LPRD/Avionics_PCB/README.md

# Avionics_PCB
EAGLE Board and schematic files
