LPRD/Avionics_PCB/Flight/CALIPSO_V3-0/Images/CALIPSO_V3-0_Render_Right1.png

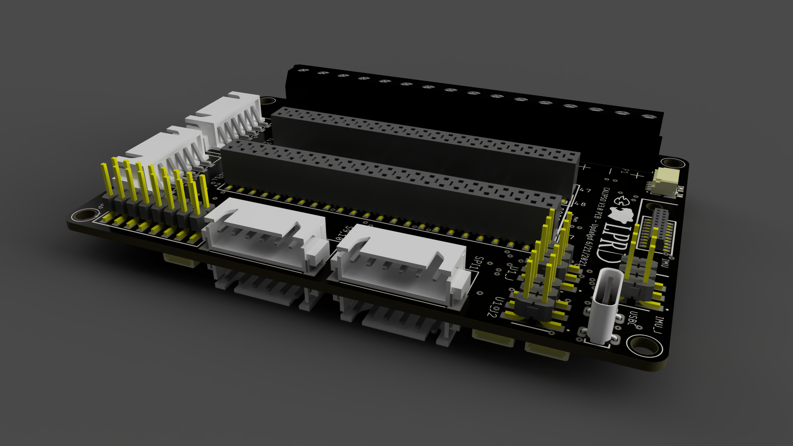
Flight/CALIPSO_V3-0/Images/CALIPSO_V3-0_Render_Right1.png
