LPRD/Avionics_PCB/Flight/CALIPSO_V3-0/Images/Eagle/CALIPSO_V3-0_Back.png

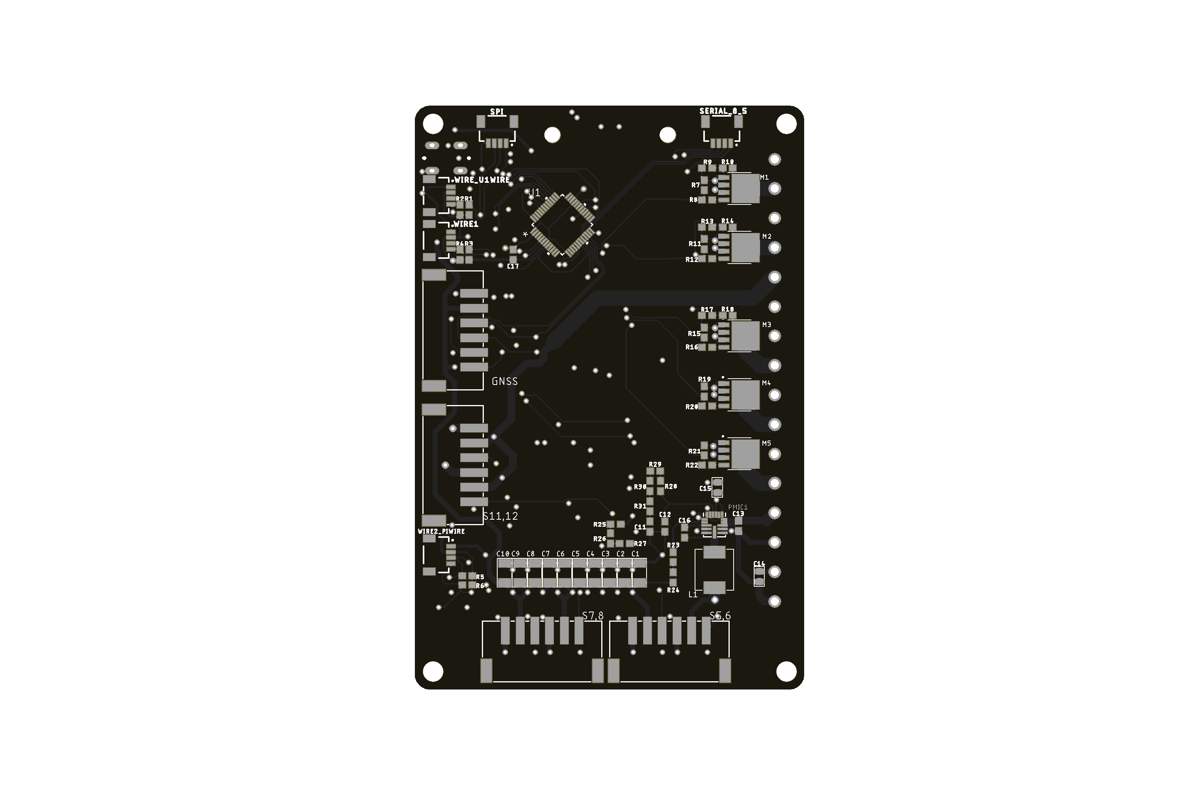
Flight/CALIPSO_V3-0/Images/Eagle/CALIPSO_V3-0_Back.png
