LPRD/Avionics_PCB/Flight/CALIPSO_V3-0/Images/Eagle/CALIPSO_V3-0_Front.png

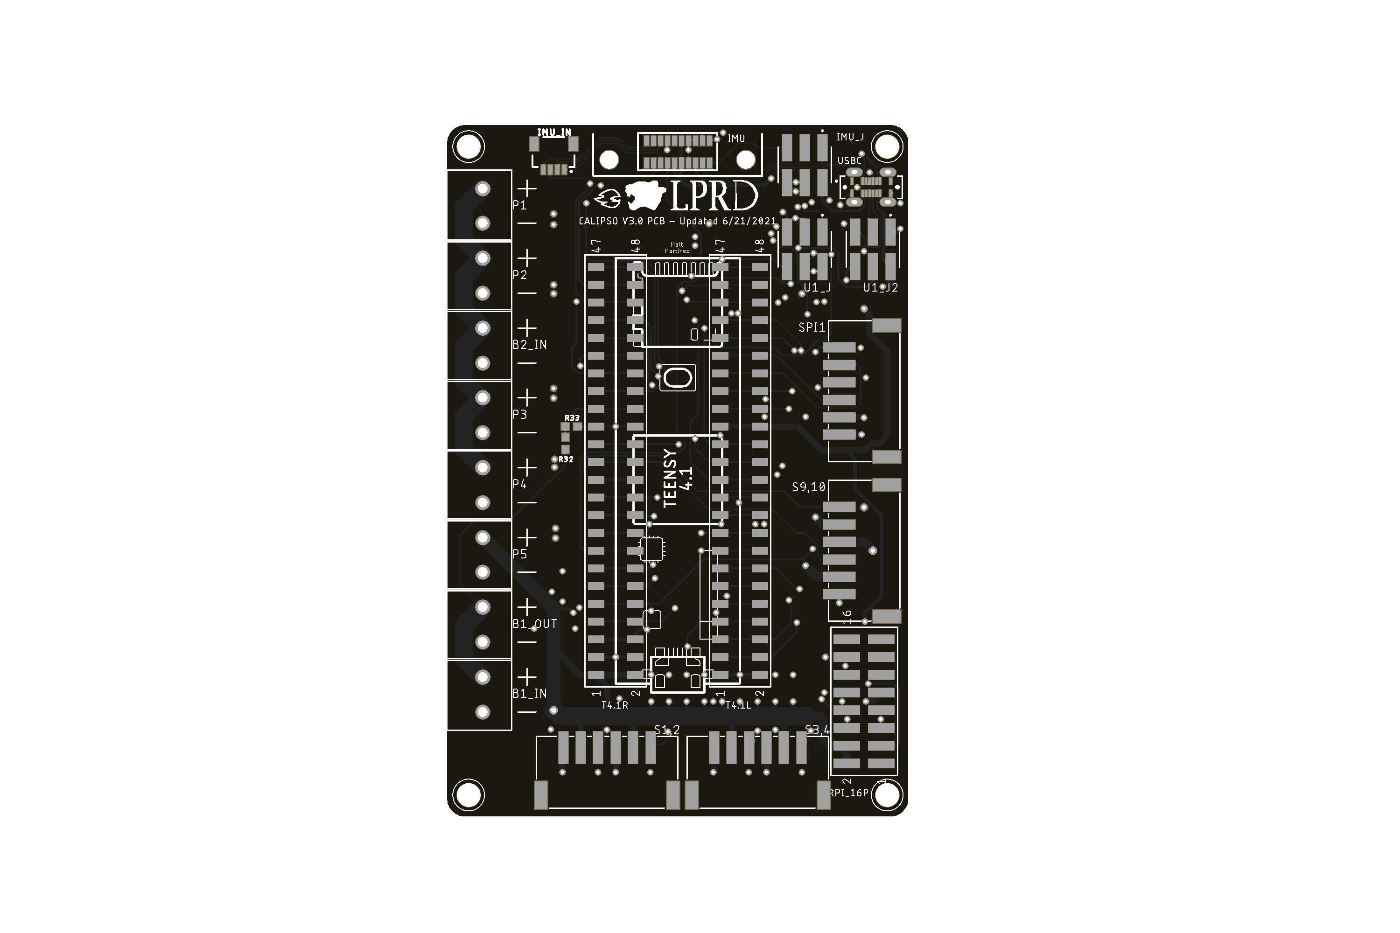
Flight/CALIPSO_V3-0/Images/Eagle/CALIPSO_V3-0_Front.png
