LPRD/Avionics_PCB/Flight/CALIPSO_V3-0/Images/Shareable/CALIPSO_V3-0_Render_Bottom45Corner1.png

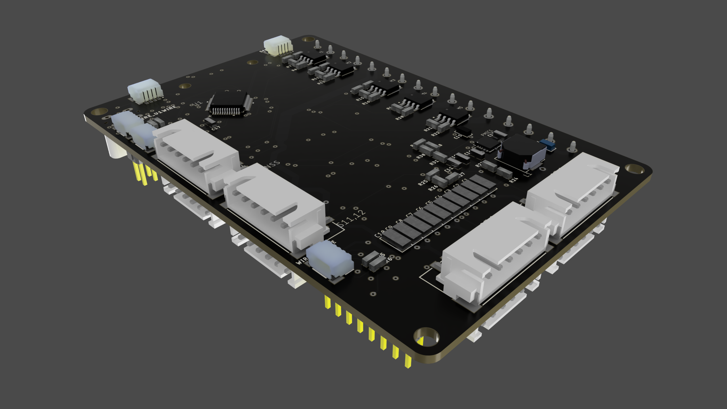
Flight/CALIPSO_V3-0/Images/Shareable/CALIPSO_V3-0_Render_Bottom45Corner1.png
