LPRD/Avionics_PCB/Flight/CALIPSO_V3-0/Images/Eagle/CALIPSO_V3-0_Front.dxf

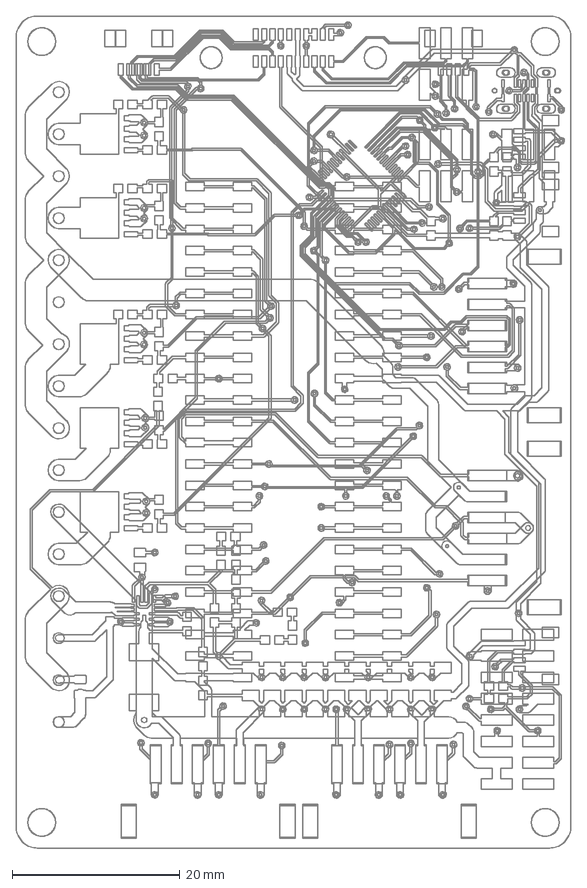
[picture p16: CAD file, 2022-03-29]
Flight/CALIPSO_V3-0/Images/Eagle/CALIPSO_V3-0_Front.dxf
66.0 x 99.1 mm
