LPRD/Avionics_PCB/Flight/CALIPSO_V3-0/Images/Eagle/CALIPSO_V3-0_Back.dxf

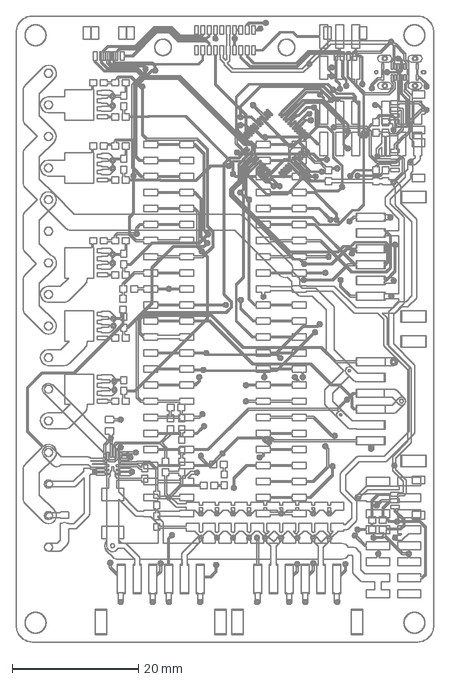
[picture p17: CAD file, 2022-03-29]
Flight/CALIPSO_V3-0/Images/Eagle/CALIPSO_V3-0_Back.dxf
66.0 x 99.1 mm
