LPRD/Avionics_PCB/ValveControl/TODO.md

# Things to fix in the valve control PCB
* Test stand blinkenlights
  * 4 of valve outputs?
  * Ignition arm/fire?
* Use switch on test stand: valve master on / off / use control panel valve master
