LPRD/Avionics_PCB/Flight/FA_2021/FA_2021_PCB_BRD_all.pdf

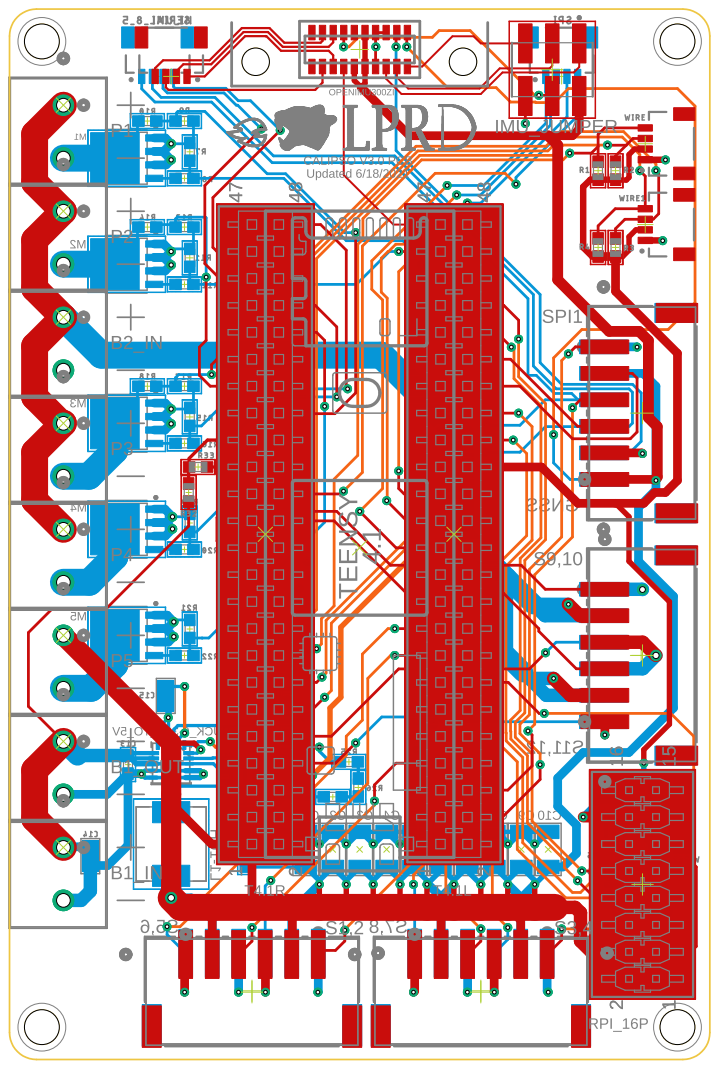
[picture p18: page 1]
