LPRD/Avionics_PCB/Flight/FA_2021/FA_2021_PCB_BRD_all_flipped.pdf

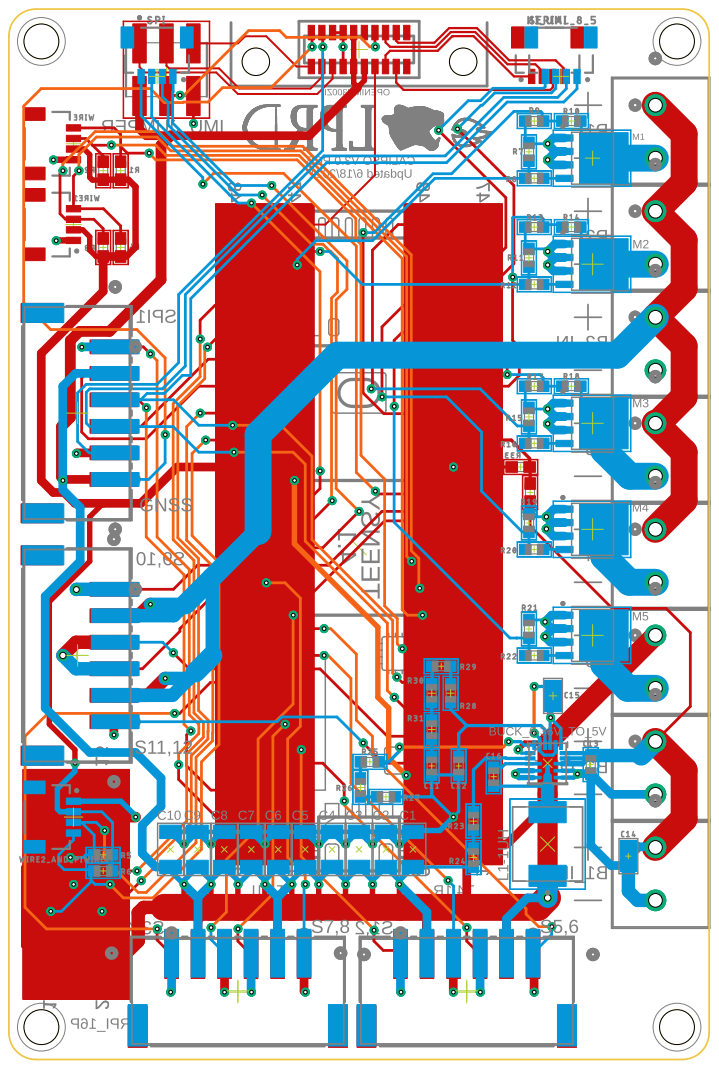
[picture p19: page 1]
