LPRD/Avionics_PCB/Flight/FA_2021/FA_2021_PCB_BRD_layer1.pdf

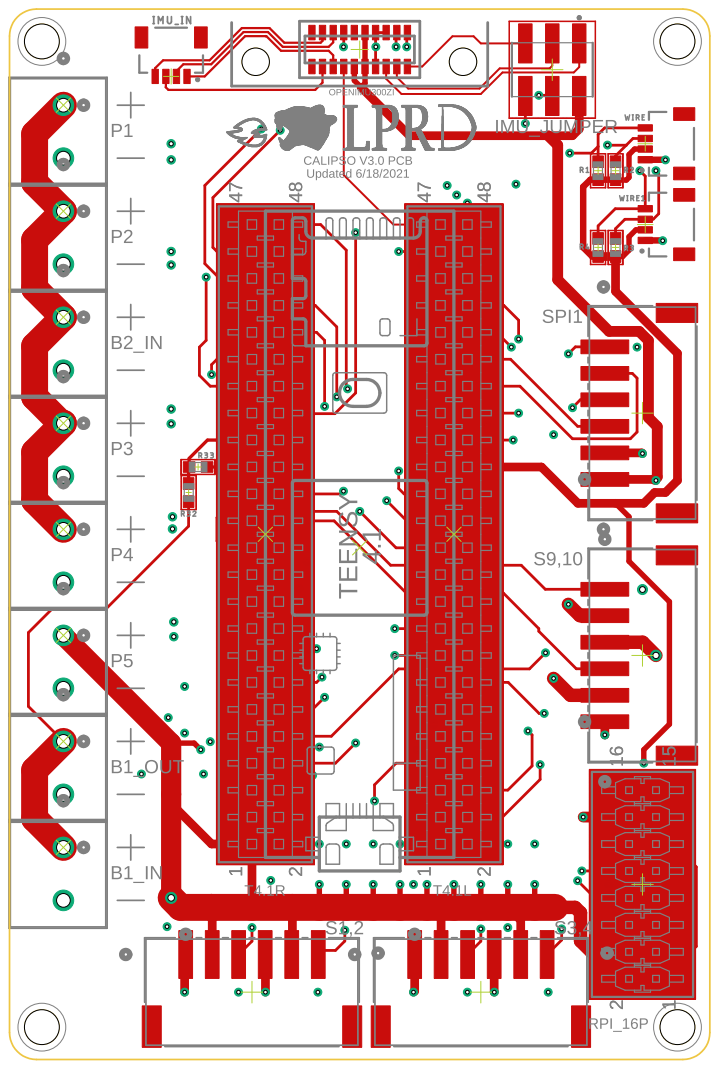
[picture p20: page 1]
