LPRD/Avionics_PCB/Flight/FA_2021/FA_2021_PCB_BRD_layer3.pdf

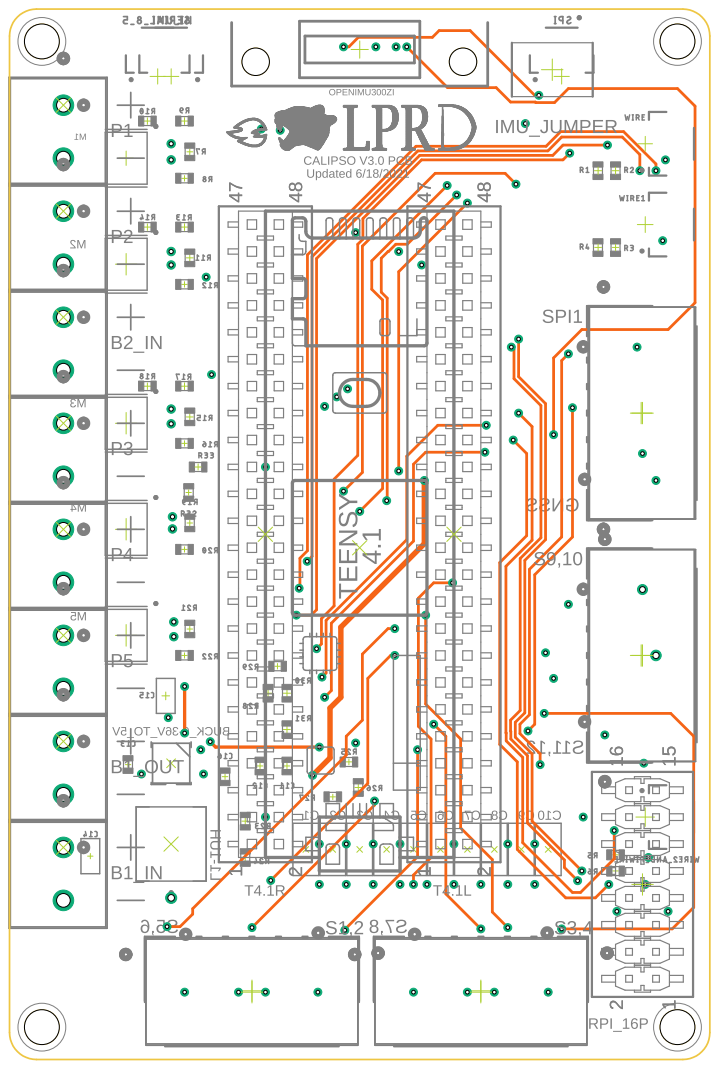
[picture p21: page 1]
