LPRD/Avionics_PCB/Flight/FA_2021/FA_2021_PCB_BRD_layer4.pdf

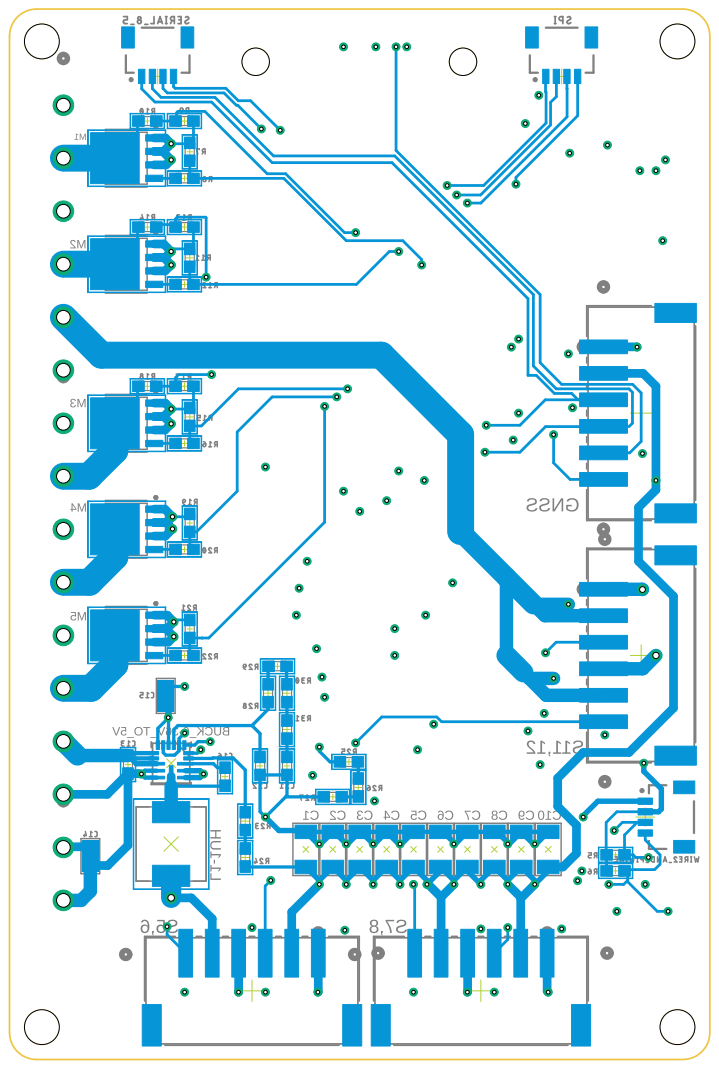
[picture p22: page 1]
