LPRD/Avionics_PCB/Flight/FA_2021/FA_2021_PCB_BRD_layer4_flipped.pdf

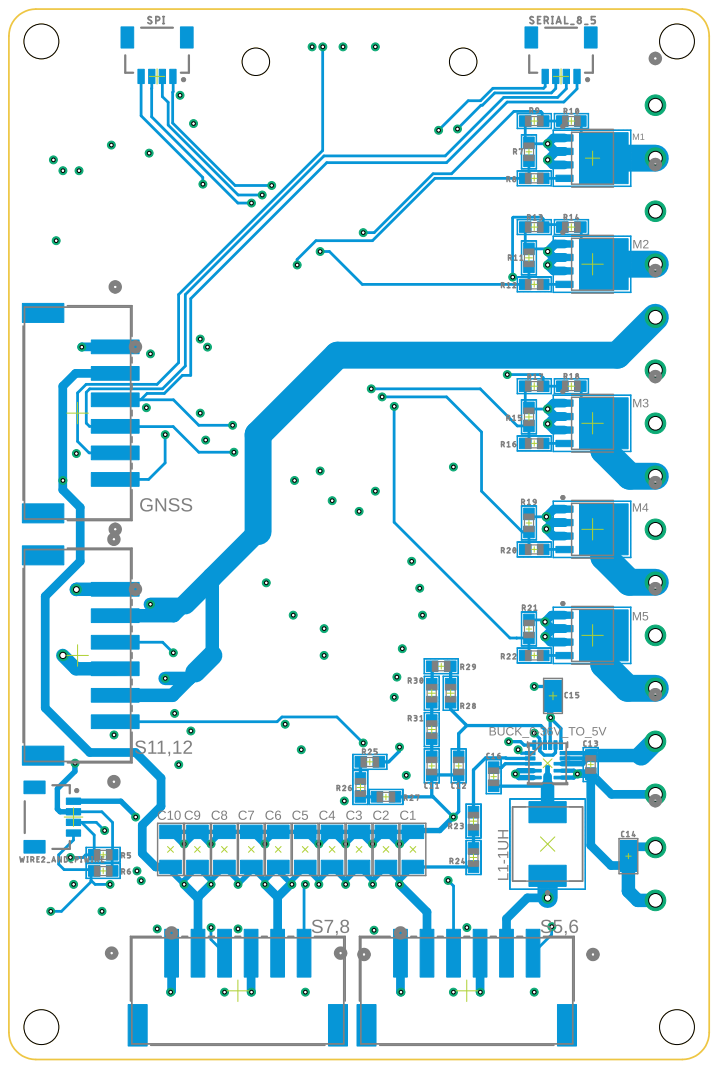
[picture p23: page 1]
