LPRD/Avionics_PCB/Flight/FA_2021/FA_2021_PCB_SCH_80.pdf

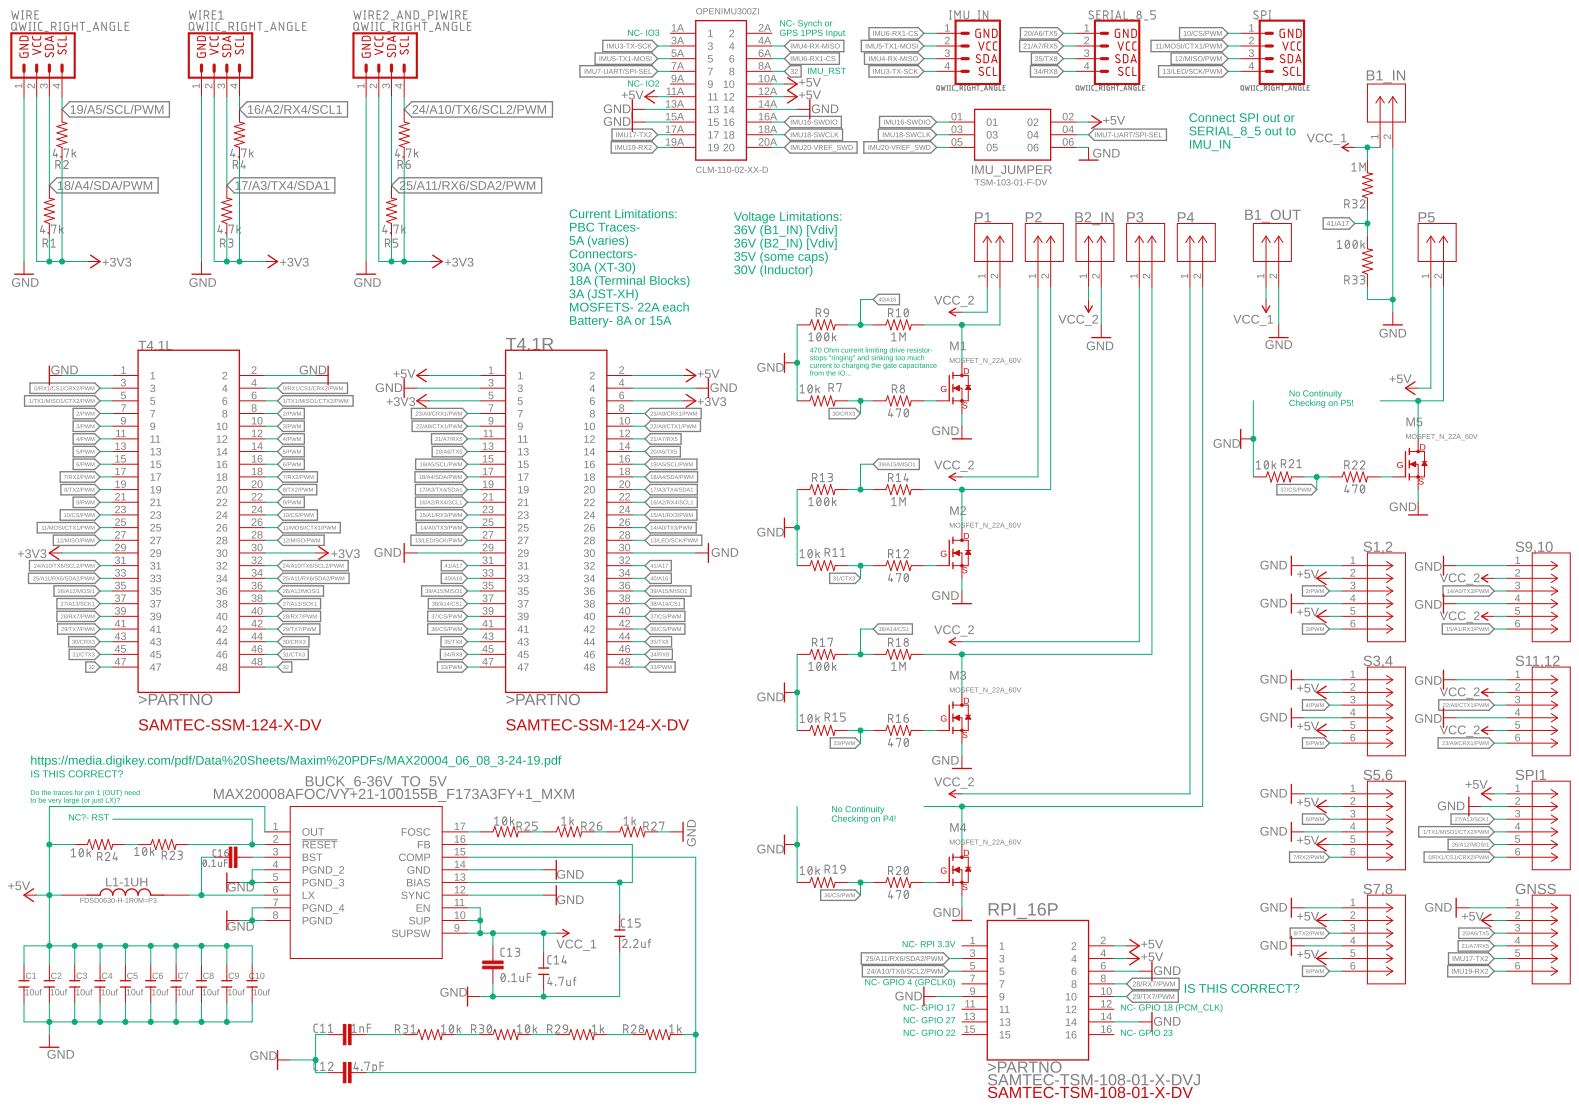
[picture p24: page 1]
