LPRD/Avionics_PCB/Flight/CALIPSO_V3-0/CALIPSO_V3-0.brd

## EAGLE design Flight/CALIPSO_V3-0/CALIPSO_V3-0.brd (2022-03-29)

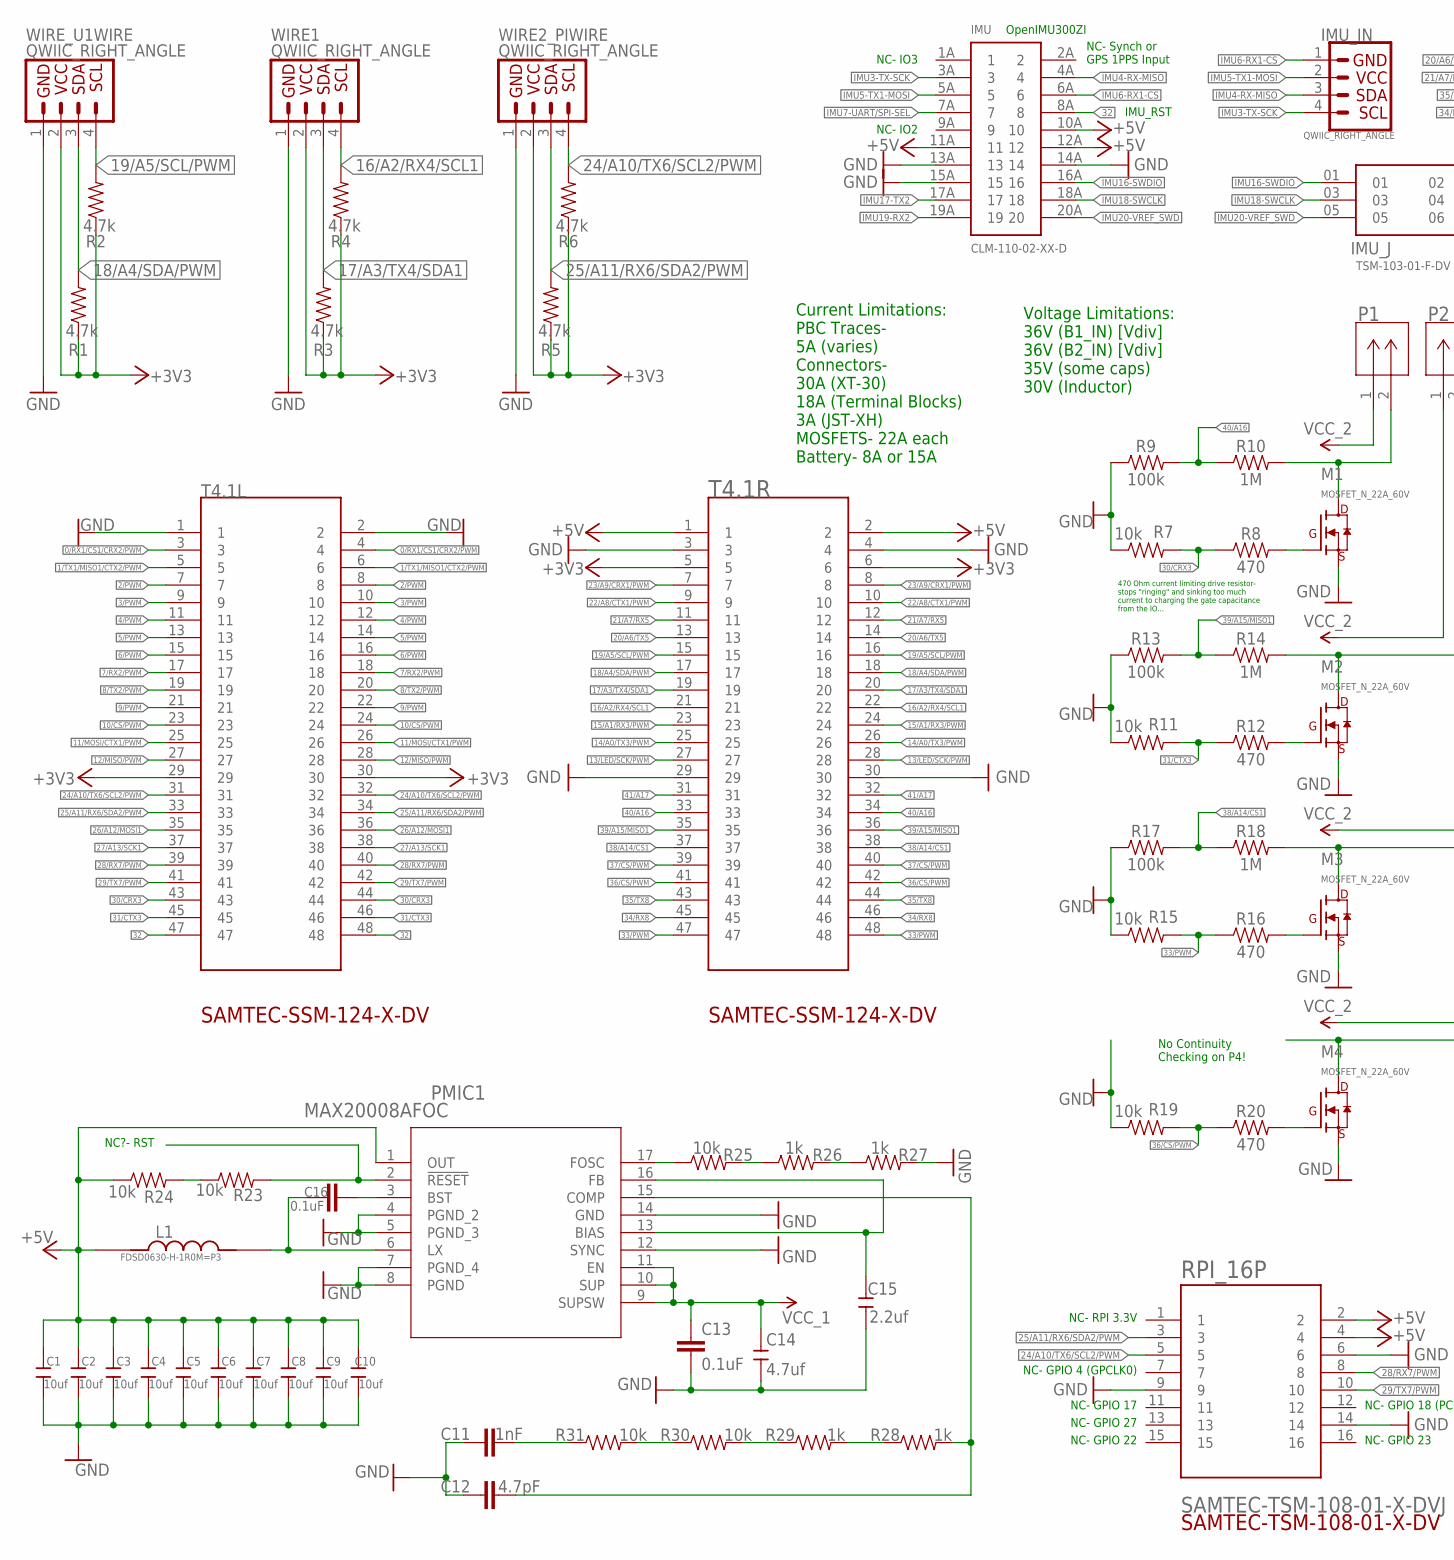
[picture p25: schematic CALIPSO_V3-0.sch, part in row 1, column 1]

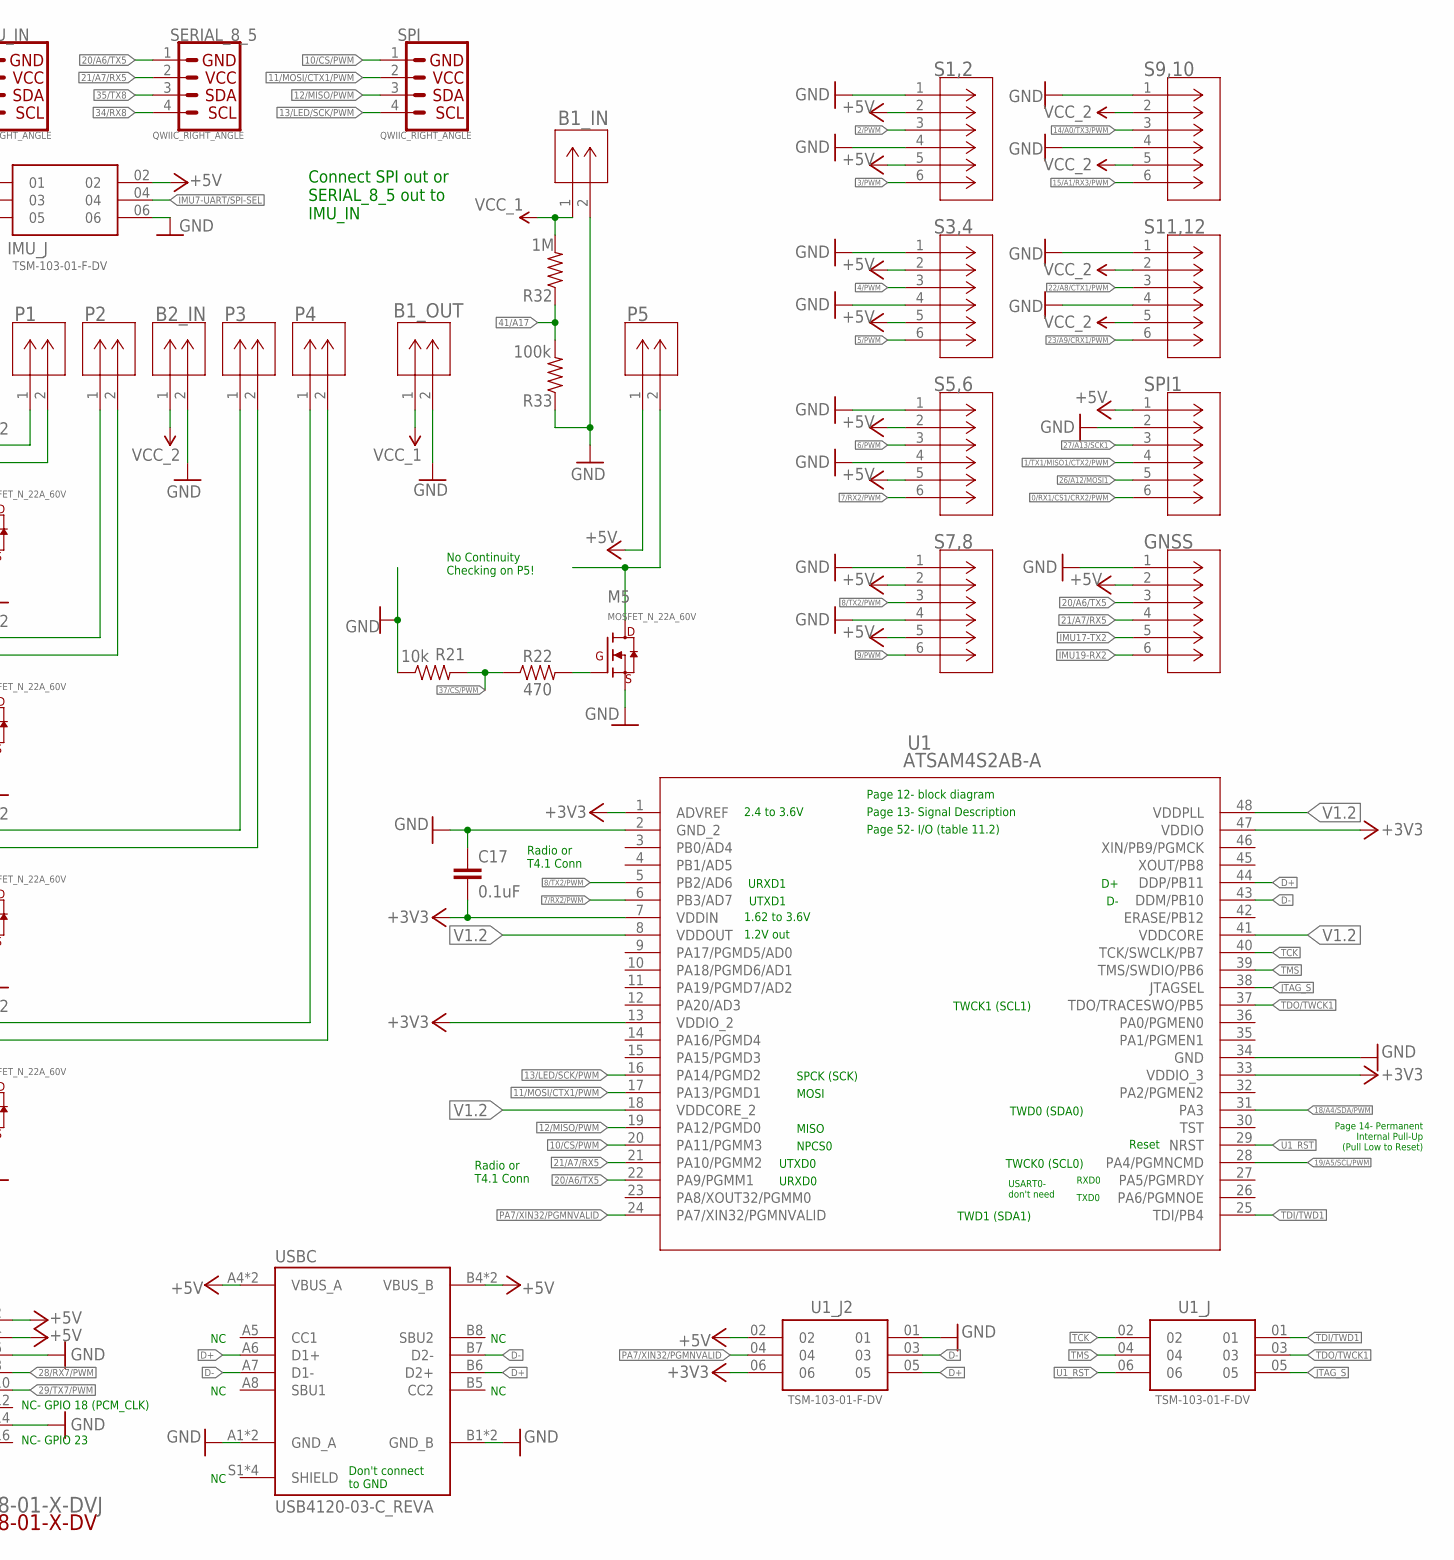
[picture p26: schematic CALIPSO_V3-0.sch, part in row 1, column 2]

Parts:
B1_IN, B1_OUT, B2_IN: TERMINAL_BLOCK_5MM_2P; TB_2P
C1, C2, C3, C4, C5, C6, C7, C8, C9, C10: 10uf; C1206
C11: 1nF; 0603
C12: 4.7pF; 0603
C13, C16, C17: 0.1uF; 0603
C14: 4.7uf; C0805
C15: 2.2uf; C0805
GNSS: JST-S6B-SH_DEV; JST-S6B-XH
IMU: CLM-110-02-XX-D; CLM-110-02-XX-D_MOD
IMU_IN: QWIIC_RIGHT_ANGLE; JST04_1MM_RA
IMU_J: TSM-103-01-F-DV; SAMTEC_TSM-103-01-F-DV
L1: FDSD0630-H-1R0M=P3; IND_FDSD0630-H-1R0M=P3
M1, M2, M3, M4, M5: MOSFET_N_22A_60V; SOT-669_LFPAK56_POWERSO8
P1, P2, P3, P4, P5: TERMINAL_BLOCK_5MM_2P; TB_2P
PMIC1: MAX20008AFOC; MAX20008AFOC_17QFN
R1, R2, R3, R4, R5, R6: 4.7k; 0603
R7, R11, R15, R19, R21, R23, R24, R25, R30, R31: 10k; 0603
R8, R12, R16, R20, R22: 470; 0603
R9, R13, R17, R33: 100k; 0603
R10, R14, R18, R32: 1M; 0603
R26, R27, R28, R29: 1k; 0603
RPI_16P: SAMTEC-TSM-108-01-X-DVJ; SAMTEC-TSM-108-01-X-DV
S1,2, S3,4, S5,6, S7,8, S9,10, S11,12: JST-S6B-SH_DEV; JST-S6B-XH
SERIAL_8_5: QWIIC_RIGHT_ANGLE; JST04_1MM_RA
SPI: QWIIC_RIGHT_ANGLE; JST04_1MM_RA
SPI1: JST-S6B-SH_DEV; JST-S6B-XH
T4.1L, T4.1R: SAMTEC-SSM-124-X-DVJ; SAMTEC-SSM-124-X-DV
U1: ATSAM4S2AB-A; ATSAM4S2AB-A_48-LQFP
U1_J, U1_J2: TSM-103-01-F-DV; SAMTEC_TSM-103-01-F-DV
USBC: USB4120-03-C_REVA; GCT_USB4120-03-C_REVA
WIRE1, WIRE2_PIWIRE: QWIIC_RIGHT_ANGLE; JST04_1MM_RA
WIRE_U1WIRE: QWIIC_RIGHT_ANGLE; JST04_1MM_RA

Connections:
0/RX1/CS1/CRX2/PWM: SPI1.6, T4.1L.3, T4.1L.4
1/TX1/MISO1/CTX2/PWM: SPI1.4, T4.1L.5, T4.1L.6
2/PWM: S1,2.3, T4.1L.7, T4.1L.8
3/PWM: S1,2.6, T4.1L.9, T4.1L.10
4/PWM: S3,4.3, T4.1L.11, T4.1L.12
5/PWM: S3,4.6, T4.1L.13, T4.1L.14
6/PWM: S5,6.3, T4.1L.15, T4.1L.16
7/RX2/PWM: S5,6.6, T4.1L.17, T4.1L.18, U1.6 (PB3/AD7)
8/TX2/PWM: S7,8.3, T4.1L.19, T4.1L.20, U1.5 (PB2/AD6)
9/PWM: S7,8.6, T4.1L.21, T4.1L.22
10/CS/PWM: SPI.1, T4.1L.23, T4.1L.24, U1.20 (PA11/PGMM3)
11/MOSI/CTX1/PWM: SPI.2, T4.1L.25, T4.1L.26, U1.17 (PA13/PGMD1)
12/MISO/PWM: SPI.3, T4.1L.27, T4.1L.28, U1.19 (PA12/PGMD0)
13/LED/SCK/PWM: SPI.4, T4.1R.27, T4.1R.28, U1.16 (PA14/PGMD2)
14/A0/TX3/PWM: S9,10.3, T4.1R.25, T4.1R.26
15/A1/RX3/PWM: S9,10.6, T4.1R.23, T4.1R.24
16/A2/RX4/SCL1: R4.2, T4.1R.21, T4.1R.22, WIRE1.4
17/A3/TX4/SDA1: R3.2, T4.1R.19, T4.1R.20, WIRE1.3
18/A4/SDA/PWM: R1.2, T4.1R.17, T4.1R.18, U1.31 (PA3), WIRE_U1WIRE.3
19/A5/SCL/PWM: R2.2, T4.1R.15, T4.1R.16, U1.28 (PA4/PGMNCMD), WIRE_U1WIRE.4
20/A6/TX5: GNSS.3, SERIAL_8_5.1, T4.1R.13, T4.1R.14, U1.22 (PA9/PGMM1)
21/A7/RX5: GNSS.4, SERIAL_8_5.2, T4.1R.11, T4.1R.12, U1.21 (PA10/PGMM2)
22/A8/CTX1/PWM: S11,12.3, T4.1R.9, T4.1R.10
23/A9/CRX1/PWM: S11,12.6, T4.1R.7, T4.1R.8
24/A10/TX6/SCL2/PWM: R6.2, RPI_16P.5, T4.1L.31, T4.1L.32, WIRE2_PIWIRE.4
25/A11/RX6/SDA2/PWM: R5.2, RPI_16P.3, T4.1L.33, T4.1L.34, WIRE2_PIWIRE.3
26/A12/MOSI1: SPI1.5, T4.1L.35, T4.1L.36
27/A13/SCK1: SPI1.3, T4.1L.37, T4.1L.38
28/RX7/PWM: RPI_16P.8, T4.1L.39, T4.1L.40
29/TX7/PWM: RPI_16P.10, T4.1L.41, T4.1L.42
30/CRX3: R7.2, R8.1, T4.1L.43, T4.1L.44
31/CTX3: R11.2, R12.1, T4.1L.45, T4.1L.46
32: IMU.8A (8), T4.1L.47, T4.1L.48
33/PWM: R15.2, R16.1, T4.1R.47, T4.1R.48
34/RX8: SERIAL_8_5.4, T4.1R.45, T4.1R.46
35/TX8: SERIAL_8_5.3, T4.1R.43, T4.1R.44
36/CS/PWM: R19.2, R20.1, T4.1R.41, T4.1R.42
37/CS/PWM: R21.2, R22.1, T4.1R.39, T4.1R.40
38/A14/CS1: R17.2, R18.1, T4.1R.37, T4.1R.38
39/A15/MISO1: R13.2, R14.1, T4.1R.35, T4.1R.36
40/A16: R9.2, R10.1, T4.1R.33, T4.1R.34
41/A17: R32.1, R33.2, T4.1R.31, T4.1R.32
+3V3: C17.2, R1.1, R2.1, R3.1, R4.1, R5.1, R6.1, T4.1L.29, T4.1L.30, T4.1R.5, T4.1R.6, U1.1 (ADVREF), U1.7 (VDDIN), U1.13 (VDDIO_2), U1.33 (VDDIO_3), U1.47 (VDDIO), U1_J2.06, WIRE1.2, WIRE2_PIWIRE.2, WIRE_U1WIRE.2
+5V: C1.2, C2.2, C3.2, C4.2, C5.2, C6.2, C7.2, C8.2, C9.2, C10.2, GNSS.2, IMU.10A (10), IMU.11A (11), IMU.12A (12), IMU_J.02, L1.1, P5.1, PMIC1.1 (OUT), R24.1, RPI_16P.2, RPI_16P.4, S1,2.2, S1,2.5, S3,4.2, S3,4.5, S5,6.2, S5,6.5, S7,8.2, S7,8.5, SPI1.1, T4.1R.1, T4.1R.2, U1_J2.02, USBC.A4 (VBUS_A), USBC.A9 (VBUS_A), USBC.B4 (VBUS_B), USBC.B9 (VBUS_B)
BIAS/FB: C15.1, PMIC1.13 (BIAS), PMIC1.16 (FB)
BST: C16.2, PMIC1.3 (BST)
BUCK_RST: PMIC1.2 (!RESET), R23.2
COMP: C12.2, PMIC1.15 (COMP), R28.2
D+: U1.44 (DDP/PB11), U1_J2.05, USBC.A6 (D1+), USBC.B6 (D2+)
D-: U1.43 (DDM/PB10), U1_J2.03, USBC.A7 (D1-), USBC.B7 (D2-)
FOSC: PMIC1.17 (FOSC), R25.1
GND: B1_IN.2, B1_OUT.2, B2_IN.2, C1.1, C2.1, C3.1, C4.1, C5.1, C6.1, C7.1, C8.1, C9.1, C10.1, C11.1, C12.1, C13.2, C14.2, C15.2, C17.1, GNSS.1, IMU.13A (13), IMU.14A (14), IMU.15A (15), IMU_J.06, M1.1 (S), M1.2 (S), M1.3 (S), M2.1 (S), M2.2 (S), M2.3 (S), M3.1 (S), M3.2 (S), M3.3 (S), M4.1 (S), M4.2 (S), M4.3 (S), M5.1 (S), M5.2 (S), M5.3 (S), PMIC1.4 (PGND_2), PMIC1.5 (PGND_3), PMIC1.7 (PGND_4), PMIC1.8 (PGND), PMIC1.12 (SYNC), PMIC1.14 (GND), R7.1, R9.1, R11.1, R13.1, R15.1, R17.1, R19.1, R21.1, R27.2, R33.1, RPI_16P.6, RPI_16P.9, RPI_16P.14, S1,2.1, S1,2.4, S3,4.1, S3,4.4, S5,6.1, S5,6.4, S7,8.1, S7,8.4, S9,10.1, S9,10.4, S11,12.1, S11,12.4, SPI1.2, T4.1L.1, T4.1L.2, T4.1R.3, T4.1R.4, T4.1R.29, T4.1R.30, U1.2 (GND_2), U1.34 (GND), U1_J2.01, USBC.A1 (GND_A), USBC.A12 (GND_A), USBC.B1 (GND_B), USBC.B12 (GND_B), WIRE1.1, WIRE2_PIWIRE.1, WIRE_U1WIRE.1
IMU3-TX-SCK: IMU.3A (3), IMU_IN.4
IMU4-RX-MISO: IMU.4A (4), IMU_IN.3
IMU5-TX1-MOSI: IMU.5A (5), IMU_IN.2
IMU6-RX1-CS: IMU.6A (6), IMU_IN.1
IMU7-UART/SPI-SEL: IMU.7A (7), IMU_J.04
IMU16-SWDIO: IMU.16A (16), IMU_J.01
IMU17-TX2: GNSS.5, IMU.17A (17)
IMU18-SWCLK: IMU.18A (18), IMU_J.03
IMU19-RX2: GNSS.6, IMU.19A (19)
IMU20-VREF_SWD: IMU.20A (20), IMU_J.05
JTAG_S: U1.38 (JTAGSEL), U1_J.05
LX: C16.1, L1.2, PMIC1.6 (LX)
unnamed: M1.4 (G), R8.2
unnamed: M5.4 (G), R22.2
unnamed: R23.1, R24.2
unnamed: M2.4 (G), R12.2
unnamed: R25.2, R26.1
unnamed: R26.2, R27.1
unnamed: R30.1, R31.2
unnamed: R29.1, R30.2
unnamed: R28.1, R29.2
unnamed: M3.4 (G), R16.2
unnamed: C11.2, R31.1
unnamed: M4.4 (G), R20.2
P1D: M1.5 (D), P1.2, R10.2
P2D: M2.5 (D), P2.2, R14.2
P3D: M3.5 (D), P3.2, R18.2
P4D: M4.5 (D), P4.2
P5D: M5.5 (D), P5.2
PA7/XIN32/PGMNVALID: U1.24 (PA7/XIN32/PGMNVALID), U1_J2.04
TCK: U1.40 (TCK/SWCLK/PB7), U1_J.02
TDI/TWD1: U1.25 (TDI/PB4), U1_J.01
TDO/TWCK1: U1.37 (TDO/TRACESWO/PB5), U1_J.03
TMS: U1.39 (TMS/SWDIO/PB6), U1_J.04
U1_RST: U1.29 (NRST), U1_J.06
V1.2: U1.8 (VDDOUT), U1.18 (VDDCORE_2), U1.41 (VDDCORE), U1.48 (VDDPLL)
VCC_1: B1_IN.1, B1_OUT.1, C13.1, C14.1, PMIC1.9 (SUPSW), PMIC1.10 (SUP), PMIC1.11 (EN), R32.2
VCC_2: B2_IN.1, P1.1, P2.1, P3.1, P4.1, S9,10.2, S9,10.5, S11,12.2, S11,12.5

Notes on the sheet:
Current Limitations: PBC Traces- 5A (varies) Connectors- 30A (XT-30) 18A (Terminal Blocks) 3A (JST-XH) MOSFETS- 22A each Battery- 8A or 15A
470 Ohm current limiting drive resistor- stops "ringing" and sinking too much current to charging the gate capacitance from the IO...
Connect SPI out or SERIAL_8_5 out to IMU_IN
IMU_RST
NC- Synch or GPS 1PPS Input
NC- IO3
NC- IO2
NC- RPI 3.3V
NC- GPIO 4 (GPCLK0)
NC- GPIO 17
NC- GPIO 27
NC- GPIO 22
NC- GPIO 18 (PCM_CLK)
NC- GPIO 23
No Continuity Checking on P4!
No Continuity Checking on P5!
NC?- RST
Voltage Limitations: 36V (B1_IN) [Vdiv] 36V (B2_IN) [Vdiv] 35V (some caps) 30V (Inductor)
2.4 to 3.6V
1.2V out
1.62 to 3.6V
Reset
Page 52- I/O (table 11.2)
RXD0
TXD0
URXD0
UTXD0
URXD1
UTXD1
Page 12- block diagram
USART0- don't need
TWD0 (SDA0)
TWCK0 (SCL0)
TWD1 (SDA1)
TWCK1 (SCL1)
NPCS0
MISO
MOSI
SPCK (SCK)
Page 13- Signal Description
OpenIMU300ZI
Don't connect to GND
Page 14- Permanent Internal Pull-Up (Pull Low to Reset)
Radio or T4.1 Conn

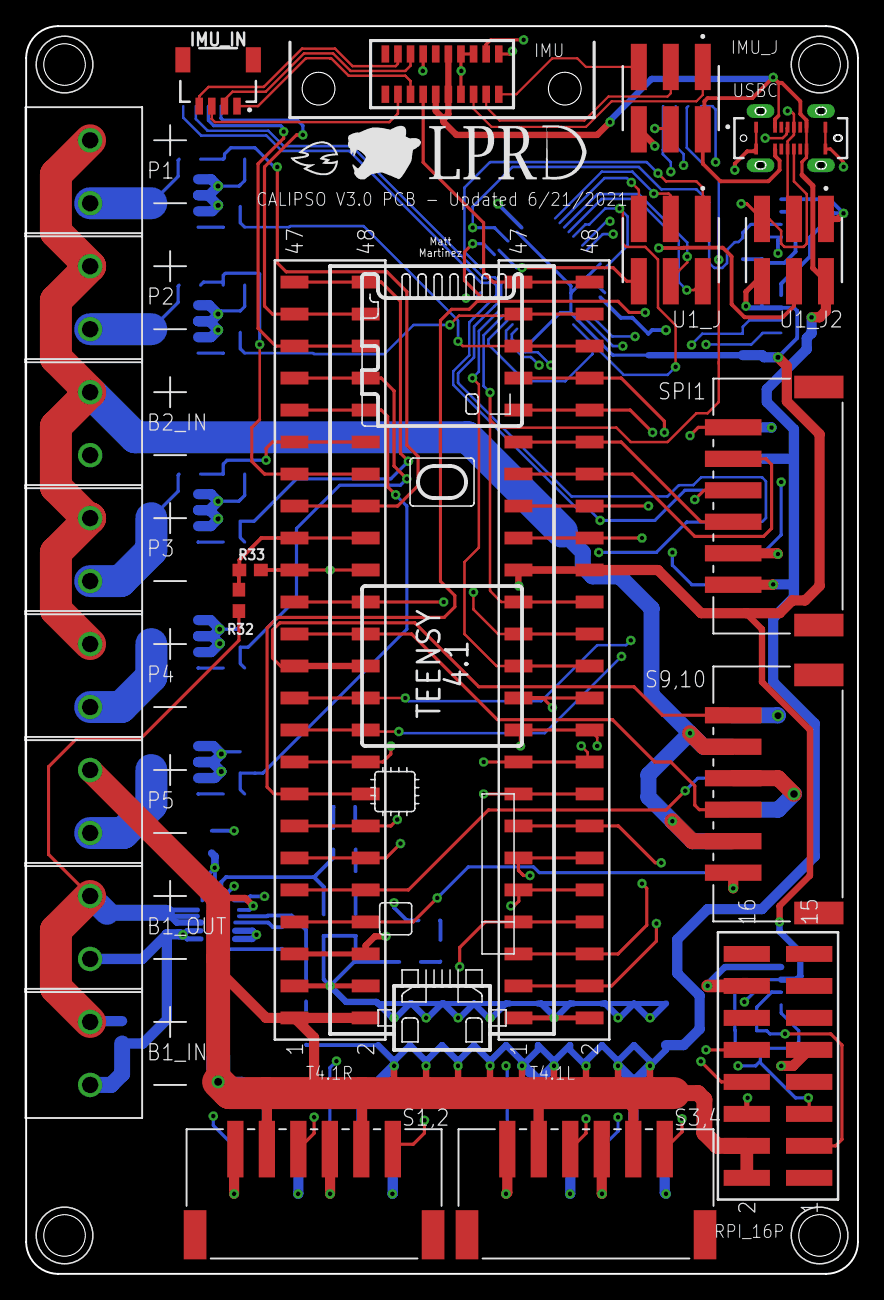
[picture p27: board CALIPSO_V3-0.brd from above]

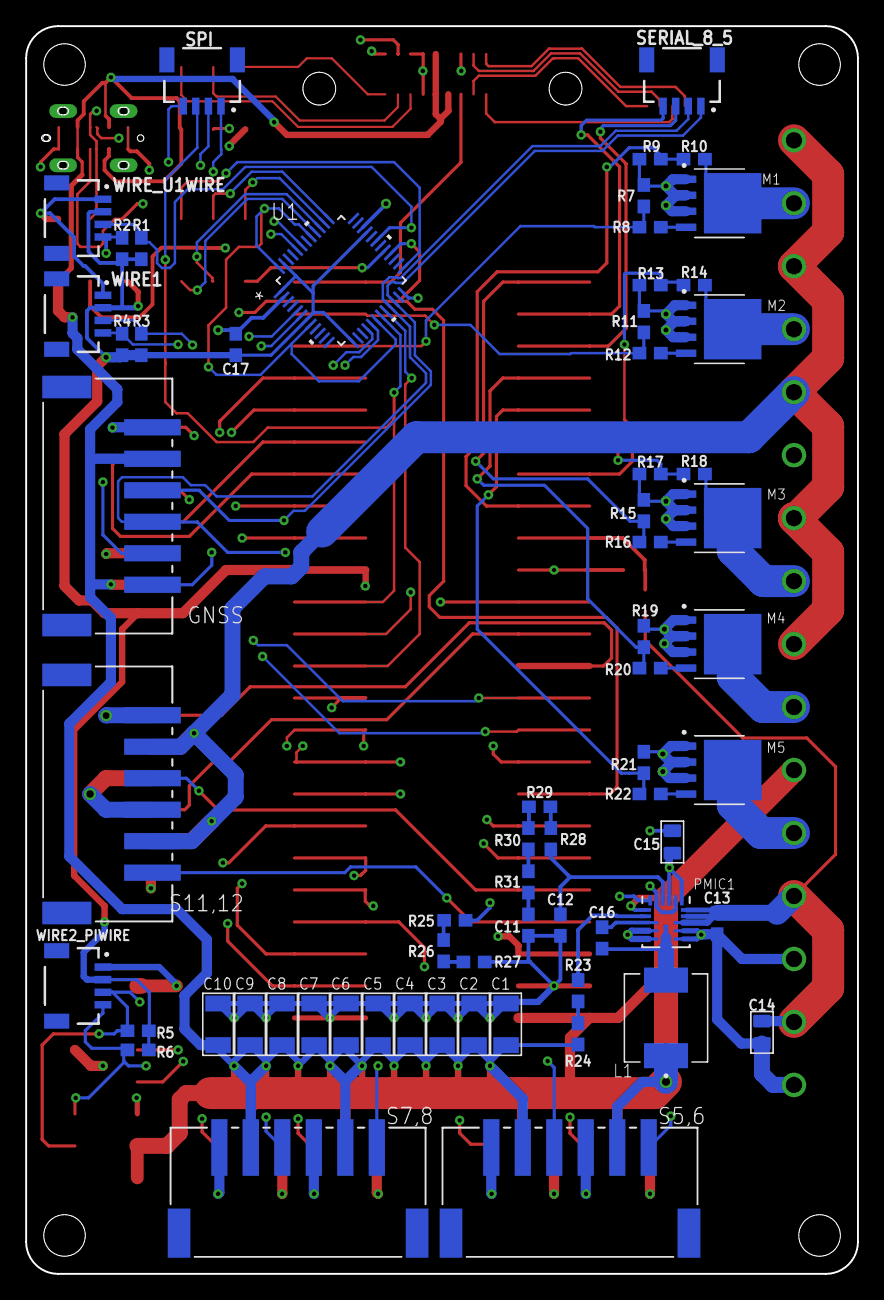
[picture p28: board CALIPSO_V3-0.brd from below]

Board: 4 copper layers, 66.0 x 99.1 mm, 89 parts (65 on the bottom side), 90 nets.

Other parts of the board:
U$1: TEENSY_4.1_SILKSCREEN
