LPRD/Avionics_PCB/ValveControl/Relay_Schem.brd

## EAGLE design ValveControl/Relay_Schem.brd (2020-03-26)

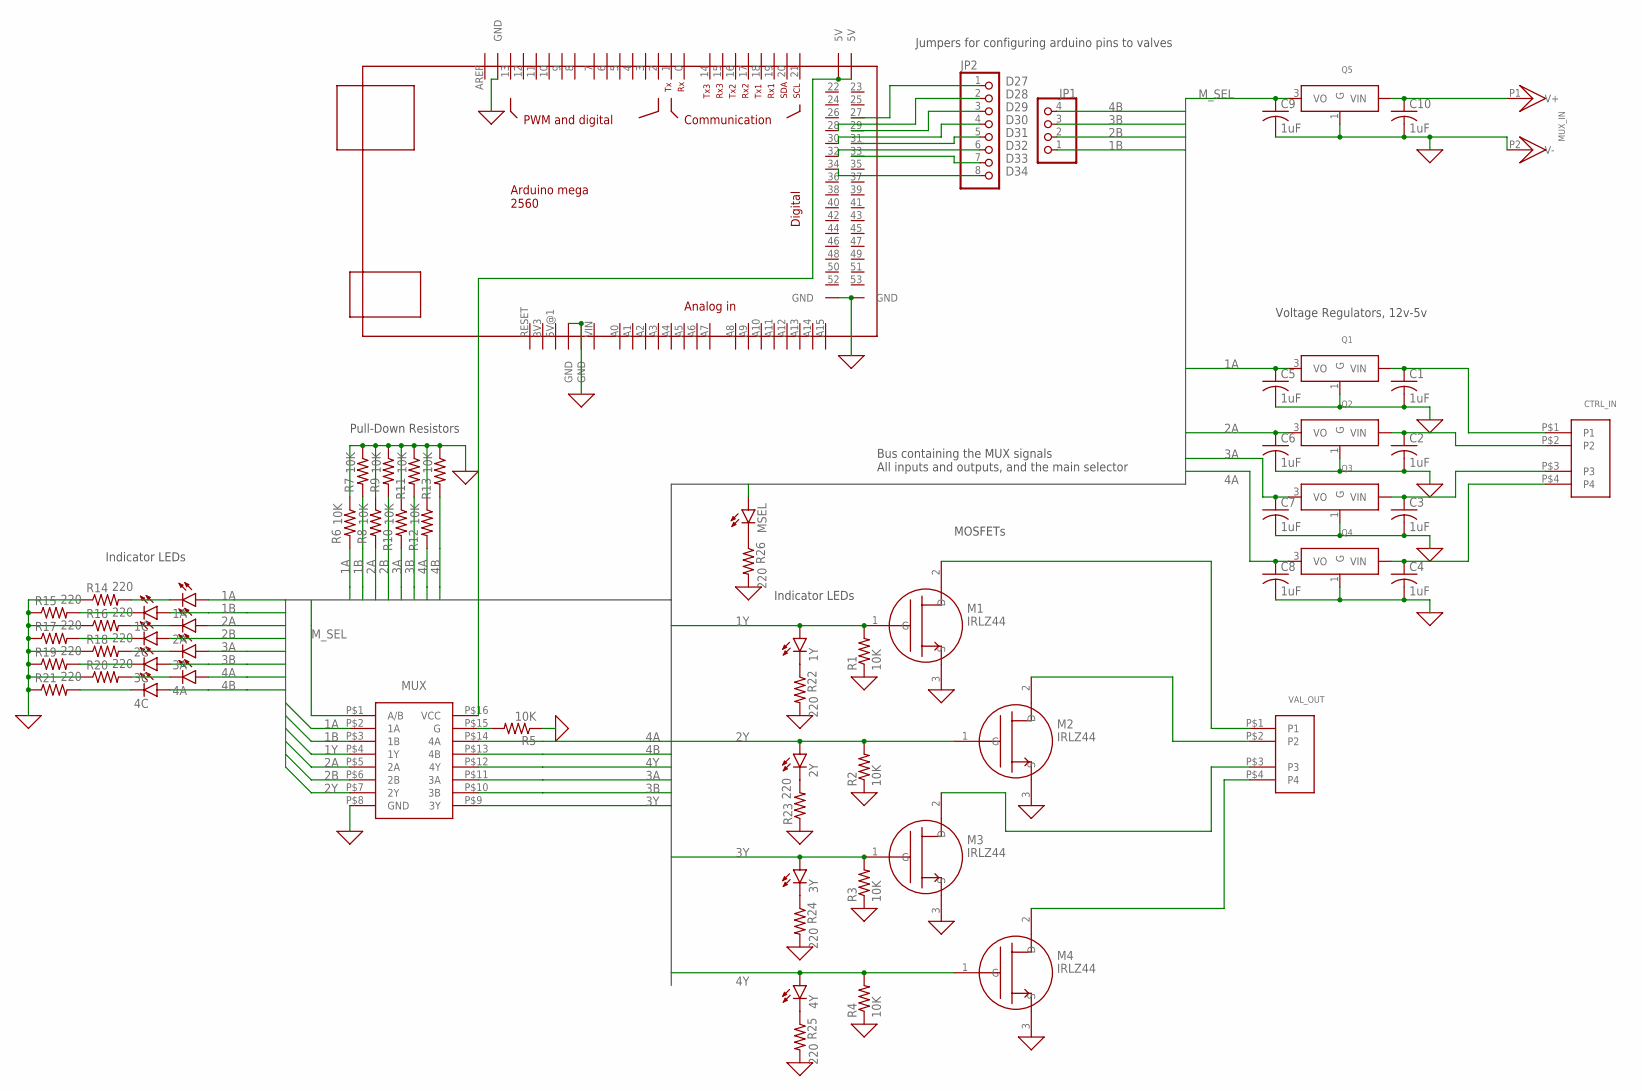
[picture p32: schematic Relay_Schem.sch]

Parts:
1A, 1C, 1Y, 2A, 2C, 2Y, 3A, 3C, 3Y, 4A, 4C, 4Y: LED3MM
C1, C2, C3, C4, C5, C6, C7, C8, C9, C10: 1uF; C025-024X044
CTRL_IN: JST_CONNECTOR; B4B-XH-A(LF)(SN)
JP1: PINHD-1X4; 1X04
JP2: PINHD-1X8; 1X08
M1, M2, M3, M4: IRLZ44; TO220V
MSEL: LED3MM
MUX: MULTIPLEXER; SN74HC157
MUX_IN: COAX_POW_2.1MM; PJ-102A
Q1, Q2, Q3, Q4, Q5: LINEAR_REGULATOR; LINREG_FP
R1, R2, R3, R4, R5, R6, R7, R8, R9, R10, R11, R12, R13: 10K; 0204/7
R14, R15, R16, R17, R18, R19, R20, R21, R22, R23, R24, R25, R26: 220; 0204/7
U$2: MEGA_DEVICE; MEGAOUTLINE
VAL_OUT: JST_CONNECTOR; B4B-XH-A(LF)(SN)

Connections:
0: C1.2, C2.2, C3.2, C4.2, C5.2, C6.2, C7.2, C8.2, C9.2, C10.2, M1.3 (S), M2.3 (S), M3.3 (S), M4.3 (S), MUX.P$8 (GND), MUX_IN.P2 (V-), Q1.1 (G), Q2.1 (G), Q3.1 (G), Q4.1 (G), Q5.1 (G), R1.1, R2.1, R3.1, R4.1, R5.1, R6.1, R7.1, R8.1, R9.1, R10.1, R11.1, R12.1, R13.1, R14.1, R15.1, R16.1, R17.1, R18.1, R19.1, R20.1, R21.1, R22.2, R23.1, R24.2, R25.2, R26.2, U$2.GND@1 (GND), U$2.GND@2 (GND), U$2.GND@3 (GND), U$2.GND@4 (GND), U$2.GND@5 (GND)
1A: 1A.A, C5.1, MUX.P$2 (1A), Q1.3 (VO), R6.2
1B: 1C.A, JP1.1, MUX.P$3 (1B), R7.2
1Y: 1Y.A, M1.1 (G), MUX.P$4 (1Y), R1.2
2A: 2A.A, C6.1, MUX.P$5 (2A), Q2.3 (VO), R8.2
2B: 2C.A, JP1.2, MUX.P$6 (2B), R9.2
2Y: 2Y.A, M2.1 (G), MUX.P$7 (2Y), R2.2
3A: 3A.A, C7.1, MUX.P$11 (3A), Q3.3 (VO), R10.2
3B: 3C.A, JP1.3, MUX.P$10 (3B), R11.2
3Y: 3Y.A, M3.1 (G), MUX.P$9 (3Y), R3.2
4A: 4A.A, C8.1, MUX.P$14 (4A), Q4.3 (VO), R12.2
4B: 4C.A, JP1.4, MUX.P$13 (4B), R13.2
4Y: 4Y.A, M4.1 (G), MUX.P$12 (4Y), R4.2
D27: JP2.1, U$2.27
D28: JP2.2, U$2.28
D29: JP2.3, U$2.29
D30: JP2.4, U$2.30
D31: JP2.5, U$2.31
D32: JP2.6, U$2.32
D33: JP2.7, U$2.33
D34: JP2.8, U$2.34
M_SEL: C9.1, MSEL.A, MUX.P$1 (A/B), Q5.3 (VO)
unnamed: C1.1, CTRL_IN.P$1 (P1), Q1.2 (VIN)
unnamed: C2.1, CTRL_IN.P$2 (P2), Q2.2 (VIN)
unnamed: M1.2 (D), VAL_OUT.P$1 (P1)
unnamed: C3.1, CTRL_IN.P$3 (P3), Q3.2 (VIN)
unnamed: M2.2 (D), VAL_OUT.P$2 (P2)
unnamed: MUX.P$16 (VCC), U$2.5V@2 (5V), U$2.5V@3 (5V)
unnamed: MSEL.K (C), R26.1
unnamed: M3.2 (D), VAL_OUT.P$3 (P3)
unnamed: M4.2 (D), VAL_OUT.P$4 (P4)
unnamed: MUX.P$15 (G), R5.2
unnamed: 1Y.K (C), R22.1
unnamed: C4.1, CTRL_IN.P$4 (P4), Q4.2 (VIN)
unnamed: 4A.K (C), R20.2
unnamed: 3A.K (C), R18.2
unnamed: 2A.K (C), R16.2
unnamed: 1A.K (C), R14.2
unnamed: 1C.K (C), R15.2
unnamed: 2C.K (C), R17.2
unnamed: 3C.K (C), R19.2
unnamed: 4C.K (C), R21.2
unnamed: 2Y.K (C), R23.2
unnamed: 3Y.K (C), R24.1
unnamed: 4Y.K (C), R25.1
unnamed: C10.1, MUX_IN.P1 (V+), Q5.2 (VIN)

Notes on the sheet:
MOSFETs
Indicator LEDs
Pull-Down Resistors
Voltage Regulators, 12v-5v
Bus containing the MUX signals All inputs and outputs, and the main selector
Jumpers for configuring arduino pins to valves
