LPRD/Avionics_PCB/ValveControl/Relay_Schem.brd

## EAGLE design ValveControl/Relay_Schem.brd (continued)

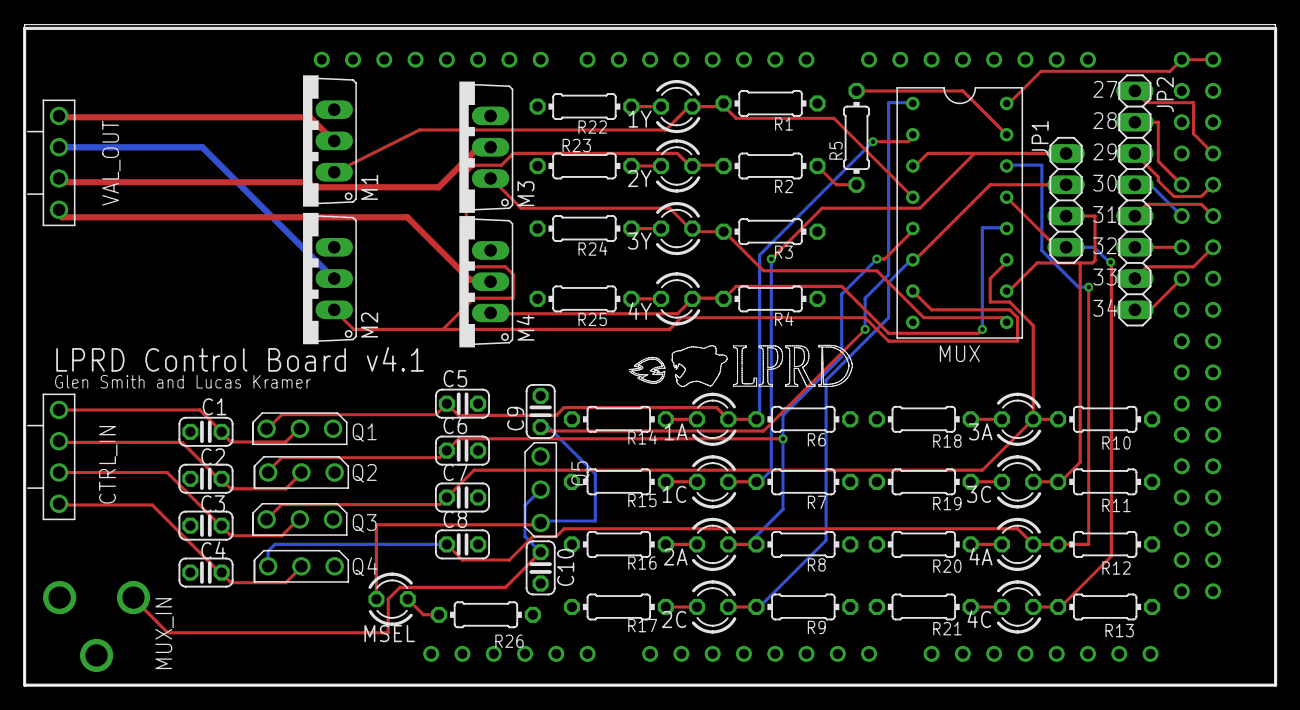
[picture p33: board Relay_Schem.brd from above]

Board: 2 copper layers, 101.6 x 53.6 mm, 65 parts (0 on the bottom side), 46 nets.
