LPRD/Avionics_PCB/Sensors/Sensors.brd

## EAGLE design Sensors/Sensors.brd (2020-03-26)

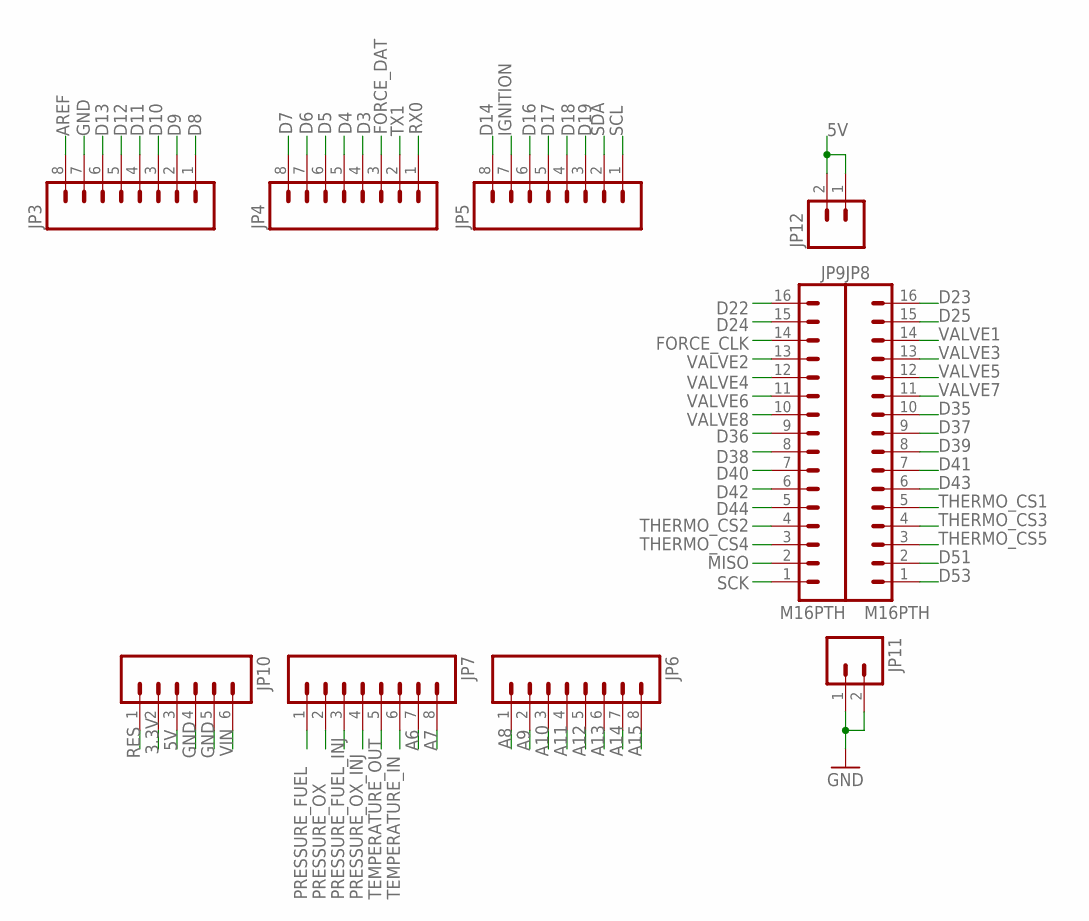
[picture p34: schematic Sensors.sch, sheet 1, <b>Main</b> <p> This sheet contains the Arduino Mega pin la…]

Parts:
JP3, JP4, JP5, JP6, JP7: M08; 1X08
JP8, JP9: M16PTH; 1X16
JP10: M06SIP; 1X06
JP11, JP12: M02PTH; 1X02

Connections:
3.3V: JP10.2
5V: JP10.3, JP12.1, JP12.2; also elsewhere on the board
A6: JP7.7
A7: JP7.8
A8: JP6.1
A9: JP6.2
A10: JP6.3
A11: JP6.4
A12: JP6.5
A13: JP6.6
A14: JP6.7
A15: JP6.8
AREF: JP3.8
D3: JP4.4
D4: JP4.5
D5: JP4.6
D6: JP4.7
D7: JP4.8
D8: JP3.1
D9: JP3.2
D10: JP3.3
D11: JP3.4
D12: JP3.5
D13: JP3.6
D14: JP5.8
D16: JP5.6
D17: JP5.5
D18: JP5.4
D19: JP5.3
D22: JP9.16
D23: JP8.16
D24: JP9.15
D25: JP8.15
D35: JP8.10
D36: JP9.9
D37: JP8.9
D38: JP9.8
D39: JP8.8
D40: JP9.7
D41: JP8.7
D42: JP9.6
D43: JP8.6
D44: JP9.5
D51: JP8.2
D53: JP8.1
FORCE_CLK: JP9.14; also elsewhere on the board
FORCE_DAT: JP4.3; also elsewhere on the board
GND: JP3.7, JP10.4, JP10.5, JP11.1, JP11.2; also elsewhere on the board
IGNITION: JP5.7
MISO: JP9.2; also elsewhere on the board
PRESSURE_FUEL: JP7.1; also elsewhere on the board
PRESSURE_FUEL_INJ: JP7.3; also elsewhere on the board
PRESSURE_OX: JP7.2; also elsewhere on the board
PRESSURE_OX_INJ: JP7.4; also elsewhere on the board
RES: JP10.1
RX0: JP4.1
SCK: JP9.1; also elsewhere on the board
SCL: JP5.1; also elsewhere on the board
SDA: JP5.2; also elsewhere on the board
TEMPERATURE_IN: JP7.6; also elsewhere on the board
TEMPERATURE_OUT: JP7.5; also elsewhere on the board
THERMO_CS1: JP8.5; also elsewhere on the board
THERMO_CS2: JP9.4; also elsewhere on the board
THERMO_CS3: JP8.4; also elsewhere on the board
THERMO_CS4: JP9.3; also elsewhere on the board
THERMO_CS5: JP8.3; also elsewhere on the board
TX1: JP4.2
VALVE1: JP8.14
VALVE2: JP9.13
VALVE3: JP8.13
VALVE4: JP9.12
VALVE5: JP8.12
VALVE6: JP9.11
VALVE7: JP8.11
VALVE8: JP9.10
VIN: JP10.6

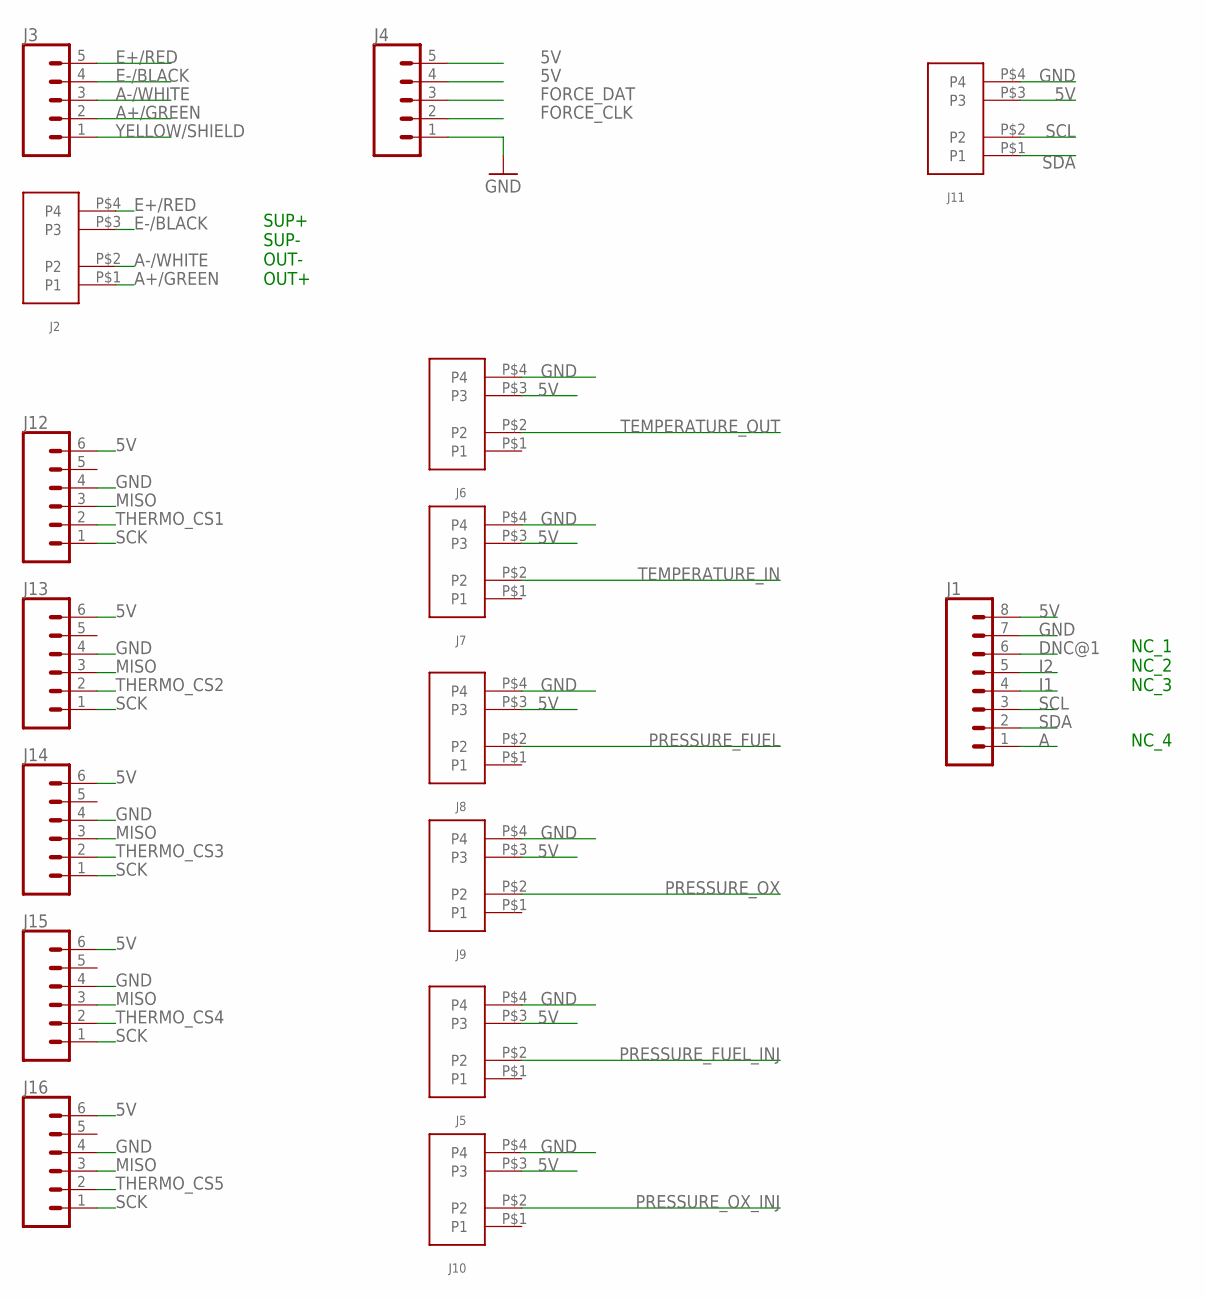
[picture p35: schematic Sensors.sch, sheet 2, <b> Sensors </b> <p> This sheet contains the following sens…]

Parts:
J1: CONN_08"; 1X08
J2, J5, J6, J7, J8, J9, J10, J11: JST_CONNECTOR; B4B-XH-A(LF)(SN)
J3, J4: CONN_05; 1X05
J12, J13, J14, J15, J16: CONN_06SILK_FEMALE_PTH; 1X06

Connections:
5V: J1.8, J4.4, J4.5, J5.P$3 (P3), J6.P$3 (P3), J7.P$3 (P3), J8.P$3 (P3), J9.P$3 (P3), J10.P$3 (P3), J11.P$3 (P3), J12.6, J13.6, J14.6, J15.6, J16.6; also elsewhere on the board
A: J1.1
A+/GREEN: J2.P$1 (P1), J3.2
A-/WHITE: J2.P$2 (P2), J3.3
DNC@1: J1.6
E+/RED: J2.P$4 (P4), J3.5
E-/BLACK: J2.P$3 (P3), J3.4
FORCE_CLK: J4.2; also elsewhere on the board
FORCE_DAT: J4.3; also elsewhere on the board
GND: J1.7, J4.1, J5.P$4 (P4), J6.P$4 (P4), J7.P$4 (P4), J8.P$4 (P4), J9.P$4 (P4), J10.P$4 (P4), J11.P$4 (P4), J12.4, J13.4, J14.4, J15.4, J16.4; also elsewhere on the board
I1: J1.4
I2: J1.5
MISO: J12.3, J13.3, J14.3, J15.3, J16.3; also elsewhere on the board
PRESSURE_FUEL: J8.P$2 (P2); also elsewhere on the board
PRESSURE_FUEL_INJ: J5.P$2 (P2); also elsewhere on the board
PRESSURE_OX: J9.P$2 (P2); also elsewhere on the board
PRESSURE_OX_INJ: J10.P$2 (P2); also elsewhere on the board
SCK: J12.1, J13.1, J14.1, J15.1, J16.1; also elsewhere on the board
SCL: J1.3, J11.P$2 (P2); also elsewhere on the board
SDA: J1.2, J11.P$1 (P1); also elsewhere on the board
TEMPERATURE_IN: J7.P$2 (P2); also elsewhere on the board
TEMPERATURE_OUT: J6.P$2 (P2); also elsewhere on the board
THERMO_CS1: J12.2; also elsewhere on the board
THERMO_CS2: J13.2; also elsewhere on the board
THERMO_CS3: J14.2; also elsewhere on the board
THERMO_CS4: J15.2; also elsewhere on the board
THERMO_CS5: J16.2; also elsewhere on the board
YELLOW/SHIELD: J3.1

Notes on the sheet:
SUP+ SUP- OUT- OUT+
NC_1 NC_2 NC_3
NC_4

Board: 2 copper layers, 28 parts (0 on the bottom side), 23 nets, no tracks yet.

Other parts of the board:
T$1: UMNLOGO
U$2: LPRDLOGO
