LPRD/Avionics_PCB/Valve 2.1/LPRD Valve Control V3.brd

## EAGLE design Valve 2.1/LPRD Valve Control V3.brd (2018-04-23)

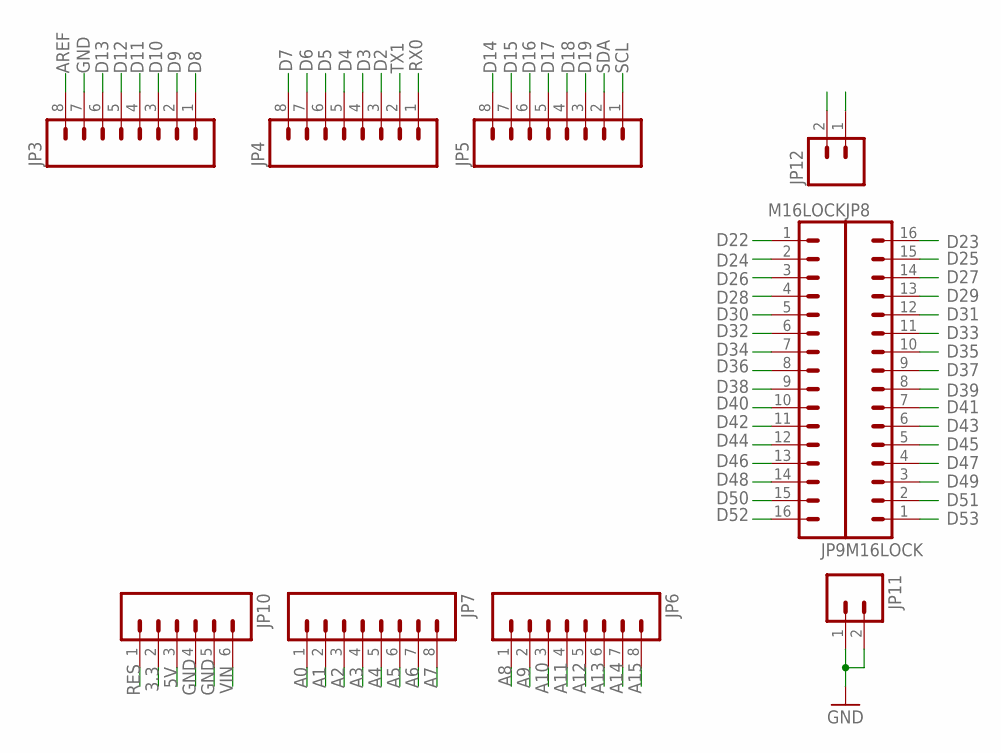
[picture p36: schematic LPRD Valve Control V3.sch, sheet 1]

Parts:
JP3, JP4, JP5, JP6, JP7: M08LOCK; 1X08_LOCK
JP8, JP9: M16LOCK; 1X16_LOCK
JP10: M06LOCK; 1X06_LOCK
JP11, JP12: M02LOCK; 1X02_LOCK

Connections:
3.3: JP10.2
5V: JP10.3
5V@1: JP12.1, JP12.2; also elsewhere on the board
A0: JP7.1
A1: JP7.2
A2: JP7.3
A3: JP7.4
A4: JP7.5
A5: JP7.6
A6: JP7.7
A7: JP7.8
A8: JP6.1
A9: JP6.2
A10: JP6.3
A11: JP6.4
A12: JP6.5
A13: JP6.6
A14: JP6.7
A15: JP6.8
AREF: JP3.8
D2: JP4.3
D3: JP4.4
D4: JP4.5
D5: JP4.6
D6: JP4.7
D7: JP4.8
D8: JP3.1
D9: JP3.2
D10: JP3.3
D11: JP3.4
D12: JP3.5
D13: JP3.6
D14: JP5.8
D15: JP5.7
D16: JP5.6
D17: JP5.5
D18: JP5.4
D19: JP5.3
D22: JP9.1
D23: JP8.16
D24: JP9.2
D25: JP8.15
D26: JP9.3
D27: JP8.14
D28: JP9.4
D29: JP8.13
D30: JP9.5
D31: JP8.12
D32: JP9.6
D33: JP8.11
D34: JP9.7
D35: JP8.10
D36: JP9.8
D37: JP8.9; also elsewhere on the board
D38: JP9.9; also elsewhere on the board
D39: JP8.8; also elsewhere on the board
D40: JP9.10; also elsewhere on the board
D41: JP8.7
D42: JP9.11
D43: JP8.6
D44: JP9.12
D45: JP8.5
D46: JP9.13
D47: JP8.4
D48: JP9.14
D49: JP8.3
D50: JP9.15
D51: JP8.2
D52: JP9.16
D53: JP8.1
GND: JP3.7, JP10.4, JP10.5, JP11.1, JP11.2; also elsewhere on the board
RES: JP10.1
RX0: JP4.1
SCL: JP5.1
SDA: JP5.2
TX1: JP4.2
VIN: JP10.6

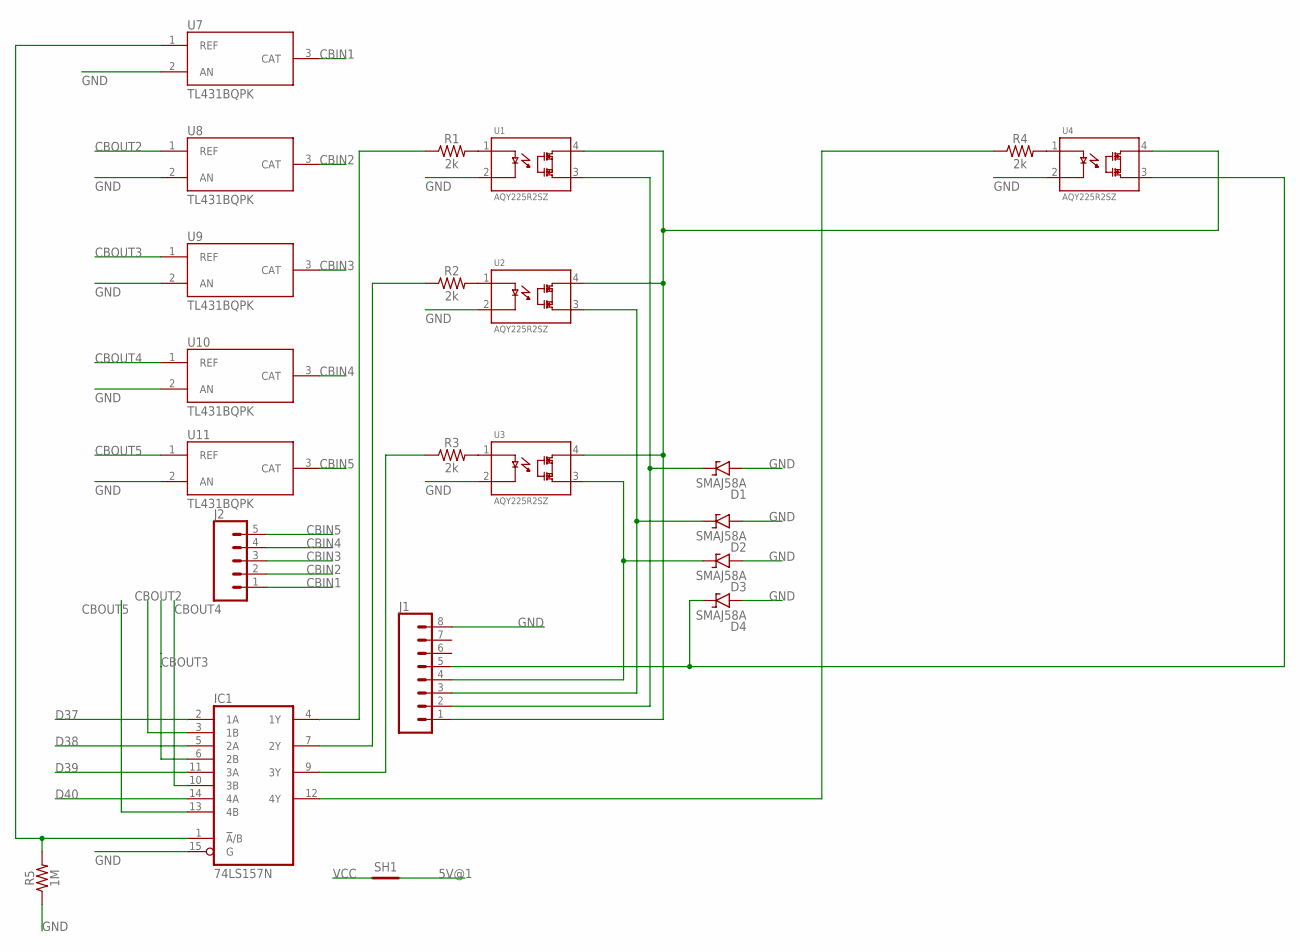
[picture p37: schematic LPRD Valve Control V3.sch, sheet 2, Valves]

Parts:
D1, D2, D3, D4: SMAJ58A; SMA
IC1: 74LS157N; DIL16
J1: CONN_08"; 1X08
J2: CONN_05; 1X05
R1, R2, R3, R4: 2k; 0805
R5: 1M; 0805
SH1: SHORTT5; SHORT_TOP-50
U1, U2, U3, U4: AQY225R2SZ; SOIC254P680X220-4N
U7, U8, U9, U10, U11: TL431BQPK; VREG_TL431BQPK

Connections:
5V@1: SH1.2; also elsewhere on the board
CBIN1: J2.1, U7.3 (CAT)
CBIN2: J2.2, U8.3 (CAT)
CBIN3: J2.3, U9.3 (CAT)
CBIN4: J2.4, U10.3 (CAT)
CBIN5: J2.5, U11.3 (CAT)
CBOUT2: IC1.3 (1B), U8.1 (REF)
CBOUT3: IC1.6 (2B), U9.1 (REF)
CBOUT4: IC1.10 (3B), U10.1 (REF)
CBOUT5: IC1.13 (4B), U11.1 (REF)
D37: IC1.2 (1A); also elsewhere on the board
D38: IC1.5 (2A); also elsewhere on the board
D39: IC1.11 (3A); also elsewhere on the board
D40: IC1.14 (4A); also elsewhere on the board
GND: D1.A, D2.A, D3.A, D4.A, IC1.8 (GND), IC1.15 (G), J1.8, R5.1, U1.2, U2.2, U3.2, U4.2, U7.2 (AN), U8.2 (AN), U9.2 (AN), U10.2 (AN), U11.2 (AN); also elsewhere on the board
unnamed: R1.2, U1.1
unnamed: R2.2, U2.1
unnamed: R3.2, U3.1
unnamed: R4.2, U4.1
unnamed: J1.1, U1.4, U2.4, U3.4, U4.4
unnamed: D1.C, J1.2, U1.3
unnamed: D2.C, J1.3, U2.3
unnamed: D3.C, J1.4, U3.3
unnamed: D4.C, J1.5, U4.3
unnamed: IC1.4 (1Y), R1.1
unnamed: IC1.7 (2Y), R2.1
unnamed: IC1.9 (3Y), R3.1
unnamed: IC1.12 (4Y), R4.1
unnamed: IC1.1 (!A!/B), R5.2, U7.1 (REF)
VCC: IC1.16 (VCC), SH1.1

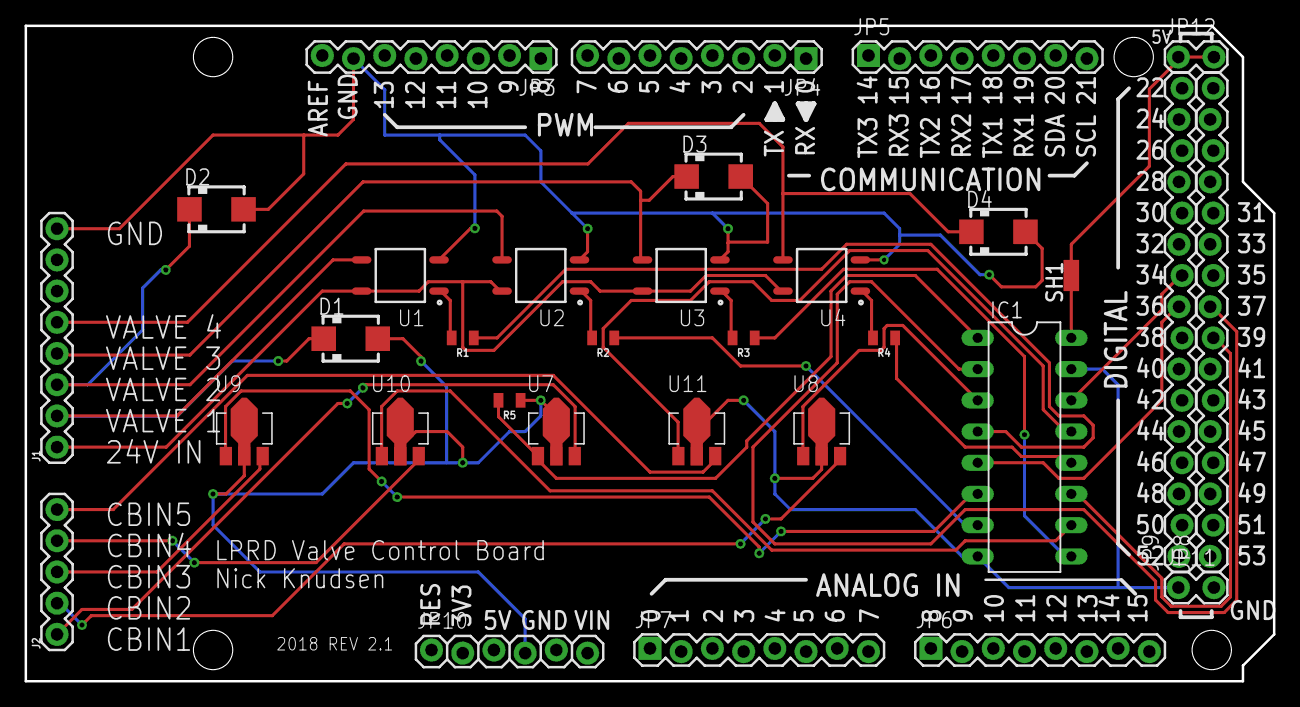
[picture p38: board LPRD Valve Control V3.brd from above]

Board: 2 copper layers, 101.6 x 53.3 mm, 34 parts (0 on the bottom side), 30 nets.

Other parts of the board:
U$1: UMNLOGO
U$2: LPRDLOGO
