LPRD/Avionics_PCB/Sensors 1.4/LPRD Sensors 1.4.brd

## EAGLE design Sensors 1.4/LPRD Sensors 1.4.brd (2018-04-09)

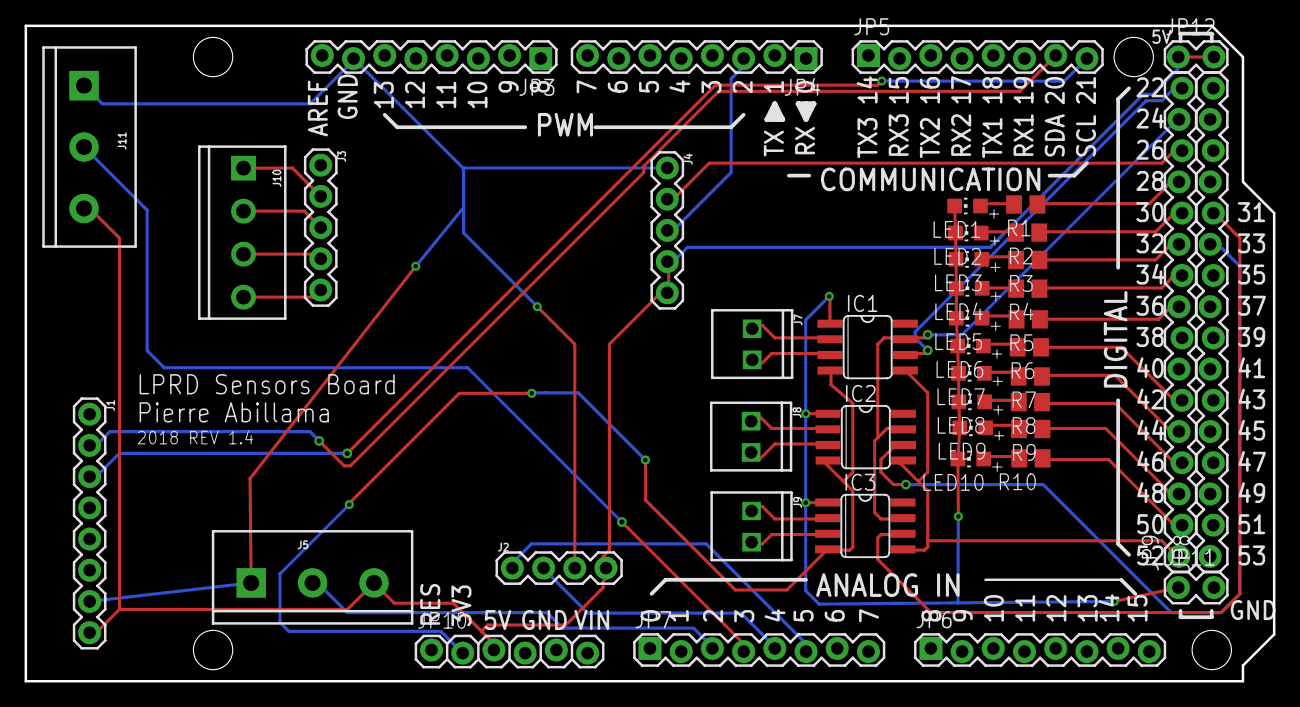
[picture p39: board LPRD Sensors 1.4.brd from above]

Board: 2 copper layers, 101.6 x 53.3 mm, 45 parts (0 on the bottom side), 46 nets.

Parts:
IC1, IC2, IC3: MAX31855; SO08
J1: 1X08
J2: 1X04
J3, J4: 1X05
J5, J11: SCREWTERMINAL-5MM-3
J7, J8, J9: 1X02_2.54_SCREWTERM
J10: SCREWTERMINAL-3.5MM-4
JP3, JP4, JP5, JP6, JP7: 1X08_LOCK
JP8, JP9: M16LOCK; 1X16_LOCK
JP10: 1X06_LOCK
JP11, JP12: 1X02_LOCK
LED1, LED2, LED3, LED4, LED5, LED6, LED7, LED8, LED9, LED10: CHIP-LED0805
R1, R2, R3, R4, R5, R6, R7, R8, R9, R10: 1000; R0805
U$1: UMNLOGO
U$2: LPRDLOGO

Connections:
3.3V: IC1.4, IC2.4, IC3.4, JP10.2
5V: J1.8, J2.4, J4.4, J4.5, J5.3, J11.3, JP10.3, JP12.1, JP12.2
A+/GREEN: J3.2, J10.1
A-/WHITE: J3.3, J10.2
E+/RED: J3.5, J10.4
E-/BLACK: J3.4, J10.3
FORCE_CLK: J4.2, JP9.14
FORCE_DAT: J4.3, JP4.3
FORCE_LED: JP9.10, R4.1
GND: IC1.1, IC2.1, IC3.1, J1.7, J2.3, J4.1, J5.1, J11.1, JP3.7, JP10.4, JP10.5, JP11.1, JP11.2, LED1.C, LED2.C, LED3.C, LED4.C, LED5.C, LED6.C, LED7.C, LED8.C, LED9.C, LED10.C
MAXCLK: IC1.5, IC2.5, IC3.5, JP9.1
MAXCS1: IC1.6, JP9.16
MAXCS2: IC2.6, JP8.11
MAXCS3: IC3.6, JP8.12
MAXDO: IC1.7, IC2.7, IC3.7, JP9.15
unnamed: LED1.A, R1.2
unnamed: LED2.A, R2.2
unnamed: LED3.A, R3.2
unnamed: LED4.A, R4.2
unnamed: LED5.A, R5.2
unnamed: LED6.A, R6.2
unnamed: LED7.A, R7.2
unnamed: IC1.2, J7.P2
unnamed: IC1.3, J7.P1
unnamed: IC2.2, J8.P2
unnamed: IC2.3, J8.P1
unnamed: IC3.2, J9.P2
unnamed: IC3.3, J9.P1
unnamed: LED8.A, R8.2
unnamed: LED9.A, R9.2
unnamed: LED10.A, R10.2
PRESSURE1_LED: JP9.9, R5.1
PRESSURE2_LED: JP9.2, R10.1
SCL: J1.3, JP5.8
SDA: J1.2, JP5.7
STATE_LED: JP9.6, R6.1
STATUS_LED: JP9.5, R7.1
TEMP1_LED: JP9.4, R8.1
TEMP2_LED: JP9.3, R9.1
THERMO1_LED: JP9.13, R1.1
THERMO2_LED: JP9.12, R2.1
THERMO3_LED: JP9.11, R3.1
VOUT_PRESSURE_1: J5.2, JP7.3
VOUT_PRESSURE_2: J11.2, JP7.4
VOUT_TEMPERATURE_1: J2.2, JP7.5
VOUT_TEMPERATURE_2: J2.1, JP7.6
