LPRD/Avionics_PCB/(commit log)

2018-04-09 Fixed SDA and SCL, fixed thermo amp 3.3
    [LPRD Sensors 1.4.brd, LPRD Sensors 1.4.sch]
2018-04-10 Added Valve control board V2.1
    [LPRD Valve Control V2.1.brd, LPRD Valve Control V2.1.sch]
2018-10-13 Updated valve board files and included gerber files
    [LPRD Valve Control V3.brd, LPRD Valve Control V3.sch]
2019-09-19 Archiving old PCBs, add new version
    [LPRD Sensors 1.4.brd, LPRD Sensors 1.4.sch, LPRD Valve Control V3.brd, LPRD Valve Control V3.sch, Relay_Schem.brd, Relay_Schem.sch]
2019-09-19 Move some components, add version number to silkscreen
    [Relay_Schem.brd]
2019-09-19 Fix voltage regulator in library
2019-09-19 Fix voltage regulators on board
    [Relay_Schem.brd, Relay_Schem.sch]
2019-09-20 More fixes/tweaks
    [Relay_Schem.brd, Relay_Schem.sch]
2019-09-20 Add logo
    [Relay_Schem.brd]
2019-09-28 Adding copied sensors PCB
    [Sensors.brd, Sensors.sch]
2019-10-05 Removed thermocouples, added JSTs
    [Sensors.brd, Sensors.sch]
2019-10-05 Updated Schematic, pins now aligned and connected
    [Sensors.brd, Sensors.sch]
2019-10-05 Rewired force JST mount
    [Sensors.brd, Sensors.sch]
2019-10-05 Refixed names on load cell JST
    [Sensors.brd, Sensors.sch]
2019-10-05 Finished routing, added accelerometer LED
    UMN Logo is on wrong side, but such is life.
    [Sensors.brd, Sensors.sch]
2019-10-05 Rearranged load cell seat, adressed errors
    [Sensors.brd, Sensors.sch]
2019-10-06 Misc. minor tweaks to routing, layout and labels
    [Sensors.brd, Sensors.sch]
2019-10-07 Some changes that I forgot to push yesterday
    [Sensors.brd]
2019-10-11 Final tweaks and minor fixes
    [Sensors.brd]
2019-10-11 Fix silkscreen to use vector fonts
    [Sensors.brd]
2019-10-11 Gerber files for version to order
2019-11-02 Fix mistakes in sensors schematic
    [Sensors.brd, Sensors.sch]
2019-11-02 Fix net naming error
    [Sensors.brd, Sensors.sch]
2019-11-09 Update version number
    [Sensors.brd]
2019-11-09 Fix misc. problems found by DRC
    [Sensors.brd]
2019-11-09 Adding gerber files
2019-11-26 Fix backwards pressure pin net names
    [Sensors.brd, Sensors.sch]
2020-02-29 Fix 5V pins in Mega shield library that were incorrectly labled as GND
2020-03-01 Update schematic for valve board
    [Relay_Schem.brd, Relay_Schem.sch]
2020-03-01 Add MOSFET to LPRD_RELAY library
2020-03-01 Fix schematic errors, finish board layout
    [Relay_Schem.brd, Relay_Schem.sch]
2020-03-01 Increase trace width between FET drains and output connector
    [Relay_Schem.brd]
2020-03-01 Add direction indication to JST connector silkscreen in library
2020-03-01 Redesign sensors PCB - remove LEDs and add additional components
    [Sensors.brd, Sensors.sch]
2020-03-01 Added new FlightPCB v1.0d
    Added new FlightPCB v1.0d to the Avionics_PCB repository
    [FlightPCB.brd, FlightPCB.sch]
2020-03-01 Change header package to remove staggered pins
    [Sensors.brd, Sensors.sch]
2020-03-03 Some minor tweaks to the layout
    [Relay_Schem.brd, Sensors.brd]
2020-03-05 Add pin numbers to valve pin selection jumper header
    [Relay_Schem.brd, Relay_Schem.sch]
2020-03-05 More final tweaks to valve board layout
    [Relay_Schem.brd]
2020-03-05 Add generated geber files for both boards
2020-03-06 Fix thermocouple amp spacing
    [Sensors.brd, Sensors.sch]
2020-03-06 Actual final version of sensors board
2020-03-24 Some minor adjustments to sensors board layout for future revisions, based on lessons learned from populating v3.0 (not routed yet)
    [Sensors.brd]
2020-03-26 Remove partial broken routing
    [Sensors.brd]
2020-03-26 Remove diodes, fix some slight layout issues
    [Relay_Schem.brd, Relay_Schem.sch]
2020-03-26 Fix MUX silkscreen layer
    [Relay_Schem.brd, Relay_Schem.sch]
2020-06-14 Fixes to Flight PCB
    Fixed hole sizing/placement, BEC clearance, GPS clearance, terminal block clearance, resistor hole spacing. Minor silkscreen adjustments
    [FlightPCB.brd, FlightPCB.sch]
2020-07-19 File System Reorganization
    Unpushed changes from 10 days ago. 6/14 has the actual changes to the board I think. This push just has changes to the folders/names so that older revisions can be found.
    [FlightPCB.brd, FlightPCB.sch]
2020-09-22 CALIPSO V2.0 Initial Commit
    initial version of the new flight computer design is done, will likely make make fixes before ordering any PCBs
    [FlightPCB.brd, FlightPCB.sch]
2020-10-11 MFG Files
    Includes PDFs and CSV files for parts... PCB file is no longer ready to order as it has to be re-routed
    [FlightPCB.brd, FlightPCB.sch, FlightPCB_BOM.csv, FlightPCB_BOM_JLC.csv, JLCSMT_Sample_BOM1.xlsx, assembly.csv, bom.csv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]
2021-01-28 Unsaved changes after 10/11/2020
    changes that I made after 10/11/2020. I don't recall what all the changes are, but I will look soon.
    [FlightPCB.brd, FlightPCB.sch]
2022-03-29 Added 2021 changes
    added changes for V3 Hardware that were done in 2021
    [CALIPSO_V3-0.brd, CALIPSO_V3-0.sch, CALIPSO_V3-0_Back.dxf, CALIPSO_V3-0_Front.dxf, FA_2021_PCB.brd, FA_2021_PCB.sch, FlightPCB.brd, FlightPCB.sch]
